SocialistDalao/UltraMIPS_Cache/ICache.runs/synth_1/.vivado.begin.rst

<?xml version="1.0"?>
<ProcessHandle Version="1" Minor="0">
    <Process Command="vivado.bat" Owner="lenovo" Host="DESKTOP-JDSOAL1" Pid="6020" HostCore="8" HostMemory="017082019840">
    </Process>
</ProcessHandle>
