SocialistDalao/UltraMIPS_Cache/ICache.runs/bank_ram_synth_1/.vivado.begin.rst

<?xml version="1.0"?>
<ProcessHandle Version="1" Minor="0">
    <Process Command="vivado.bat" Owner="Lenovo" Host="DESKTOP-DE0831E" Pid="9336" HostCore="12" HostMemory="017056509952">
    </Process>
</ProcessHandle>
