SocialistDalao/UltraMIPS_Cache/Resource/pref_pass_49/myCPU/Readme.md

大赛要求的顶层模块：mycpu_top（待修改）

cpu外的顶层模块：CacheBeta1以及my_axi_interface

宏定义：defines_cache

其他文件包含在模块内部，顶层接线不需要涉及。
