SocialistDalao/UltraMIPS_Cache/Thoughts.md

# Cache开发说明

当前目录下为成品的流水ICache与成品的DCache。目前ICache支持双发，具体更新见Cache_Desgin.md

#### 流水线思考

DCache的一部分遗留问题如下：首先是结构和状态机不能够与流水线进行对接，同时整个流水线的结构显得扑朔迷离，不仅如此，当前的代码和数据通路的构造显得不够清晰和合理，状态机的设计也存在着相当的不合理性。关于将bank的各部分的写使能分开，不要一起写，这个等整个的功能一步一步开发之后再进行重构和关键路径的优化。还有就是假如是两级的流水线，那么如果读和（脏数据）写冲突了，那么就应该是写优先。写数据会比读数据慢一拍，这样的话就刚好碰在一起，就不用读RAM了，只执行写操作，对于读操作直接拿写的数据就好了（好有道理，这不就解决了写相关）。

对于信号func，之后切成流水的时候要注意到流水线中的无效情况，也是就是不是二选一的关系，还需要加入无效。则之后换成write_valid和read_valid信号。

cache这边基本确定，取指和访存最好是三级而非两级，也就是cpu至少是7级流水。

只要是流水，就不得不考虑到数据冲突，对于读将要写的似乎显得容易解决，但是如果是考虑到WriteBuffer，似乎一切都不是那么简单。写WriteBuffer的时候也有可能同时在读，其中会不会出现数据冲突呢？所以在构建流水之前还是需要先思考一下Cache中的数据通路，准确而优雅的展示出硬件框图和其中的联系关系。

#### 状态机非流水思考

##### 状态机

现在的状态机基本符合预期，但是在Look Up和Write Data两个状态没有太多的操作，很多操作都在fetch data中，其中写ram的操作也在这里完成，因此可以考虑之后从中分配一部分操作出去。

##### WriteBuffer满

当前，我们设计的DCache为当从总线获得数据的时候，对buffer写入脏块，当buffer为满的时候，我们设计暂停，但是注意，这样导致弹出来的快丢失了。所以我们应该要在一开始就暂停住状态机，在buffer满的时候不进行工作。但是由于我们的buffer较大，现在还没有遇到这种问题，因此我们暂时不修复。

#### 结构设计文档

对于cache的结构和设计的思想的文档都在Cache_Design.md中，但是里面目前的不仅不全面而且有部分未更新，并且排版偏向混乱，至于具体的结构设计文档，包括硬件框图，都会在单发射性能测试成功后或者是双发射性能测试成功之后进行补充。为了方便团队内部和之后学校内部的传承，这都是必须要做的事情。

至于开源版本，可能会有一定设计上的精简，考虑到整个比赛的良性循环以及学习精神，开源版本应该附加的Cache Design更加注重原理上而非细节上的设计，这两个版本将为校内同学的学习提供Cache设计的参考。

结构设计文档应该要详细的标注出各个端口和各个部件的功能特性和时序图，不能够草草了事。

#### 紧接着要做的事情

- DCache仿真

#### 剩余待实现的功能

- 流水切割（初具成果的cache）
- Cache指令
- 硬件初始化（决赛的基本要求）
- 指令预取
- 双发射（最终成品的cache的基础版）
- 开发文档和结构设计的撰写
- 这之后就是各种提升性能的关键所在了
