SocialistDalao/UltraMIPS_Cache/Resource/PastVersion/7.28中午将分支预测正确工作.md

### 版本

7.28noon：功能测试通过。性能测试有分，但是部分不显示，应该是axi跑飞了。

### 进程

7.28中午将分支预测正确工作

7.27晚 dcache过了性能测试
