SocialistDalao/UltraMIPS_Cache/Resource/PastVersion/7.28noon-InstUncached/ctrl.v

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
`include "defines.v"

module ctrl(
	input resetn,
	input stallreq_from_id,
	input stallreq_from_ex,
	input stallreq_from_icache,
	input stallreq_from_dcache,
	input pred_flag,
	input exception_flag,
	input[4:0] exception_type,
	input[`InstAddrBus] cp0_epc_i,
	
	output reg[5:0]          stall,
	output reg               flush,
	output reg               flush_cause,
	output reg[`InstAddrBus] epc_o

);

	always @ (*) begin
		if (resetn == `RstEnable) stall = 6'b000000;
		else if (stallreq_from_dcache == `Stop) stall = 6'b011111;
		else if (stallreq_from_ex == `Stop) stall = 6'b001111;
		else if (stallreq_from_id == `Stop) stall = 6'b000111;
		else if (stallreq_from_icache == `Stop) stall = 6'b000111;
		else stall = 6'b000000;
	end
	
	always @ (*) begin
	   if (resetn == `RstEnable) begin
	       flush = `NoFlush;
	       flush_cause = `Exception;
	       epc_o = `ZeroWord;
	   end else if (exception_flag == `ExceptionInduced) begin
	       flush = `Flush;
	       flush_cause = `Exception;
	       case (exception_type)
	       `EXCEPTION_INT, `EXCEPTION_ADEL, `EXCEPTION_ADES, `EXCEPTION_SYS,
	       `EXCEPTION_BP, `EXCEPTION_RI, `EXCEPTION_OV, `EXCEPTION_TR: epc_o = `VECTOR_EXCEPTION;
	       `EXCEPTION_ERET: epc_o = cp0_epc_i;
	       default: epc_o = `ZeroWord;
	       endcase
	   end else if (pred_flag == `InvalidPrediction) begin
	       flush = `Flush;
	       flush_cause = `FailedBranchPrediction;
	       epc_o = `ZeroWord;
	   end else begin
	       flush = `NoFlush;
	       flush_cause = `Exception;
	       epc_o = `ZeroWord;
	   end
	end

endmodule
