SocialistDalao/UltraMIPS_Cache/Resource/submission_prelininary/src/mycpu/mycpu.v

//////////////////////////////////////////////////////////////////////////////////
// Company: 
// Engineer: 
// 
// Create Date: 2020/06/24 16:48:43
// Design Name: 
// Module Name: mycpu
// Project Name: 
// Target Devices: 
// Tool Versions: 
// Description: 
// 
// Dependencies: 
// 
// Revision:
// Revision 0.01 - File Created
// Additional Comments:
// 
//////////////////////////////////////////////////////////////////////////////////


module mycpu(
    input clk,
    input resetn,
    input[5:0] int,
    output flush,
    output timer_int_o,
    
    // 与I-cache交流
    input stallreq_from_icache,
    input[`InstBus] inst1_from_icache,
    input[`InstBus] inst2_from_icache,
    input[`InstAddrBus] inst1_addr_from_icache,
    input[`InstAddrBus] inst2_addr_from_icache,
    input[`SIZE_OF_CORR_PACK] corr_pack0_from_cache_o,
    input[`SIZE_OF_CORR_PACK] corr_pack1_from_cache_o,
    input inst1_valid_from_icache,
    input inst2_valid_from_icache,
    output rreq_to_icache,
    output[`InstAddrBus] raddr_to_icache,
    
    //Cache Pc Control
    input [`InstAddrBus] npc_from_cache_i,
    
    //bpu
    output[`SIZE_OF_CORR_PACK] corr_pack0_to_cache_o,
    output[`SIZE_OF_CORR_PACK] corr_pack1_to_cache_o,
	output 				is_pc_branch_i,
	output 				is_pcPlus4_branch_i,
	output [`InstAddrBus]	pc_branch_dest_i,
	output [`InstAddrBus]	pcPlus4_branch_dest_i,
    
    // 与D-cache交流
    input[`RegBus] rdata_from_dcache,
    input stallreq_from_dcache,
    output rreq_to_dcache,
    output[`DataAddrBus] raddr_to_dcache,
    output wreq_to_dcache,
    output[`DataAddrBus] waddr_to_dcache,
    output[`RegBus] wdata_to_dcache,
    output[3:0] wsel_to_dcache,
    
    // debug信号
    output[`InstAddrBus]           commit_pc1,
	output                         commit_rf_wen1,
	output[4:0]                    commit_rf_waddr1,
	output[`RegBus]                commit_rf_wdata1,
	
	output[`InstAddrBus]           commit_pc2,
	output                         commit_rf_wen2,
	output[`RegAddrBus]            commit_rf_waddr2,
	output[`RegBus]                commit_rf_wdata2
    
    );
    
    wire[3:0] stall;
    wire flush_cause;
    wire flush_to_ibuffer;
    wire stallreq_from_ex;
    wire stallreq_from_id;
    wire[`InstAddrBus] epc_o;
    wire ibuffer_full;
    
    wire rf_we1;
    wire rf_we2;
    wire[`RegAddrBus] rf_waddr1;
    wire[`RegAddrBus] rf_waddr2;
    wire[`RegAddrBus] rf_raddr1;
    wire[`RegAddrBus] rf_raddr2;
    wire[`RegAddrBus] rf_raddr3;
    wire[`RegAddrBus] rf_raddr4;
    wire[`RegBus] rf_wdata1;
    wire[`RegBus] rf_wdata2;
    wire[`RegBus] rf_rdata1;
    wire[`RegBus] rf_rdata2;
    wire[`RegBus] rf_rdata3;
    wire[`RegBus] rf_rdata4;
    
    wire[`RegBus] hi_i;
    wire[`RegBus] lo_i;
    wire we_hilo;
    wire[`RegBus] hi_o;
    wire[`RegBus] lo_o;
    
    wire LLbit_i;    

    wire LLbit_we;
    wire LLbit_o;
    wire cp0_we;
    wire[2:0] cp0_wsel;
    wire[2:0] cp0_rsel;
    wire[`RegAddrBus] cp0_waddr;
    wire[`RegAddrBus] cp0_raddr;
    wire[`RegBus] cp0_wdata;
    wire[`RegBus] cp0_rdata;
    wire[`RegBus] cp0_badvaddr;
    wire[`RegBus] cp0_count;
    wire[`RegBus] cp0_compare;
    wire[`RegBus] cp0_status;
    wire[`RegBus] cp0_cause;
    wire[`RegBus] cp0_epc;
    wire[`RegBus] cp0_config;
    wire[`RegBus] cp0_prid;
    wire[`RegBus] cp0_ebase;
    
    
    wire[`SIZE_OF_CORR_PACK] inst1_bpu_corr_i;
    wire[`SIZE_OF_CORR_PACK] inst2_bpu_corr_i;
    wire[`SIZE_OF_BRANCH_INFO] branch_info_i;
    
    wire id_issue_en_i;
    wire[`InstBus] id_inst1_i;
    wire[`InstBus] id_inst2_i;
    wire[`InstAddrBus] id_inst1_addr_i;
    wire[`InstAddrBus] id_inst2_addr_i;
    wire[`SIZE_OF_CORR_PACK] id_inst1_bpu_corr_i;
    wire[`SIZE_OF_CORR_PACK] id_inst2_bpu_corr_i;
    
    wire id_is_in_delayslot_i;
    
    
    wire[`InstAddrBus] id_inst1_addr_o;
    wire[`InstAddrBus] id_inst2_addr_o;
    wire[`SIZE_OF_CORR_PACK] id_inst1_bpu_corr_o;
    wire[`SIZE_OF_CORR_PACK] id_inst2_bpu_corr_o;
    wire[`AluOpBus] id_aluop1_o;
    wire[`AluOpBus] id_aluop2_o;
    wire[`AluSelBus] id_alusel1_o;
    wire[`AluSelBus] id_alusel2_o;
    wire[`RegBus] id_reg1_o;
    wire[`RegBus] id_reg2_o;
    wire[`RegBus] id_reg3_o;
    wire[`RegBus] id_reg4_o;
    wire[`RegAddrBus] id_waddr1_o;
    wire[`RegAddrBus] id_waddr2_o;
    wire id_we1_o;
    wire id_we2_o;
    wire[`RegBus] id_hi_o;
    wire[`RegBus] id_lo_o;
    wire[`RegBus] id_imm_fnl1_o;
    wire[2:0] id_cp0_sel_o;
    wire[`RegAddrBus] id_cp0_addr_o;
    wire id_issue_mode_o;
    wire id_issued_o;
    wire id_is_in_delayslot1_o;
    wire id_is_in_delayslot2_o;
    wire next_inst_in_delayslot;
    wire[31:0] id_exception_type1_o;
    wire[31:0] id_exception_type2_o;
    
    wire mul_s;
    wire mul_req;
    wire mul_ready;
    wire[`DoubleRegBus] mul_result;
    
    wire signed_div;
    wire[`RegBus] div_opdata1;
    wire[`RegBus] div_opdata2;
    wire div_start;
    wire[`DoubleRegBus] div_result;
    wire div_ready;
    
    wire[`InstAddrBus] ex_inst1_addr_i;
    wire[`InstAddrBus] ex_inst2_addr_i;
    wire[`SIZE_OF_CORR_PACK] ex_inst1_bpu_corr_i;
    wire[`SIZE_OF_CORR_PACK] ex_inst2_bpu_corr_i;
    wire[`AluOpBus] ex_aluop1_i;
    wire[`AluOpBus] ex_aluop2_i;
    wire[`AluSelBus] ex_alusel1_i;
    wire[`AluSelBus] ex_alusel2_i;
    wire[`RegBus] ex_reg1_i;
    wire[`RegBus] ex_reg2_i;
    wire[`RegBus] ex_reg3_i;
    wire[`RegBus] ex_reg4_i;
    wire[`RegAddrBus] ex_waddr1_i;
    wire[`RegAddrBus] ex_waddr2_i;
    wire ex_we1_i;
    wire ex_we2_i;
    wire[`RegBus] ex_hi_i;
    wire[`RegBus] ex_lo_i;
    wire[`RegBus] ex_imm_fnl1_i;
    wire ex_issue_i;
    wire[2:0] ex_cp0_sel_i;
    wire[`RegAddrBus] ex_cp0_addr_i;
    wire ex_is_in_delayslot1_i;
    wire ex_is_in_delayslot2_i;
    wire[31:0] ex_exception_type1_i;
    wire[31:0] ex_exception_type2_i;
    
    wire[`InstAddrBus] ex_inst1_addr_o;
    wire[`InstAddrBus] ex_inst2_addr_o;
    wire[`SIZE_OF_CORR_PACK] ex_inst1_bpu_corr_o;
    wire[`SIZE_OF_CORR_PACK] ex_inst2_bpu_corr_o;
    wire[`RegAddrBus] ex_waddr1_o;
    wire[`RegAddrBus] ex_waddr2_o;
    wire ex_we1_o;
    wire ex_we2_o;
    wire[`RegBus] ex_wdata1_o;
    wire[`RegBus] ex_wdata2_o;
    wire[`RegBus] ex_hi_o;
    wire[`RegBus] ex_lo_o;
    wire ex_whilo_o;
    wire[`AluOpBus] ex_aluop1_o;
    wire[`RegBus] ex_mem_addr_o;
    wire[`RegBus] ex_reg2_o;
    wire ex_LLbit_o;
    wire ex_LLbit_we_o;
    wire[`InstAddrBus] ex_npc_actual_o;
    wire ex_branch_flag_o;
	wire ex_pred_flag_o;
    wire[`SIZE_OF_BRANCH_INFO] ex_branch_info_o;
	wire ex_issue_mode_o;
    wire[2:0] ex_cp0_wsel_o;
	wire ex_cp0_we_o;
	wire[`RegAddrBus] ex_cp0_waddr_o;
	wire[`RegBus] ex_cp0_wdata_o;
	wire ex_is_in_delayslot1_o;
    wire ex_is_in_delayslot2_o;
    wire[31:0] ex_exception_type1_o;
    wire[31:0] ex_exception_type2_o;
    
    wire[`InstAddrBus] mem_inst1_addr_i;
    wire[`InstAddrBus] mem_inst2_addr_i;
    wire[`RegAddrBus] mem_waddr1_i;
    wire[`RegAddrBus] mem_waddr2_i;
    wire mem_we1_i;
    wire mem_we2_i;
    wire[`RegBus] mem_wdata1_i;
    wire[`RegBus] mem_wdata2_i;
    wire[`RegBus] mem_hi_i;
    wire[`RegBus] mem_lo_i;
    wire mem_whilo_i;
    wire[`AluOpBus] mem_aluop1_i;
    wire[`RegBus] mem_mem_addr_i;
    wire[`RegBus] mem_reg2_i;
    wire mem_LLbit_i;
    wire mem_LLbit_we_i;
    wire[2:0] mem_cp0_wsel_i;
    wire mem_cp0_we_i;
	wire[`RegAddrBus] mem_cp0_waddr_i;
	wire[`RegBus] mem_cp0_wdata_i;
	wire mem_is_in_delayslot1_i;
    wire mem_is_in_delayslot2_i;
    wire[31:0] mem_exception_type1_i;
    wire[31:0] mem_exception_type2_i;
    
    wire[`InstAddrBus] mem_inst1_addr_o;
    wire[`InstAddrBus] mem_inst2_addr_o;
    wire[`RegAddrBus] mem_waddr1_o;
    wire[`RegAddrBus] mem_waddr2_o;
    wire mem_we1_o;
    wire mem_we2_o;
    wire[`RegBus] mem_wdata1_o;
    wire[`RegBus] mem_wdata2_o;
    wire[`RegBus] mem_hi_o;
    wire[`RegBus] mem_lo_o;
    wire mem_whilo_o;
    wire[`RegBus] mem_mem_addr_o;
    wire mem_LLbit_o;
    wire mem_LLbit_we_o;
    wire[2:0] mem_cp0_wsel_o;
    wire mem_cp0_we_o;
	wire[`RegAddrBus] mem_cp0_waddr_o;
	wire[`RegBus] mem_cp0_wdata_o;
	wire mem_is_in_delayslot1_o;
    wire mem_is_in_delayslot2_o;
    wire[4:0] mem_exception_type_o;
    wire mem_exception_flag_o;
    wire mem_exception_first_inst_o;
    wire[`InstAddrBus] latest_epc;
    wire[`InstAddrBus] mem_ebase_o;
    wire[`InstAddrBus] commit_pc_o;
    
    // Debug信号
    
    assign commit_pc1 = commit_pc_o;
    assign commit_rf_wen1 = rf_we1;
    assign commit_rf_waddr1 = rf_waddr1;
    assign commit_rf_wdata1 = rf_wdata1;
    assign commit_pc2 = commit_pc_o + 4'h4;
    assign commit_rf_wen2 = rf_we2;
    assign commit_rf_waddr2 = rf_waddr2;
    assign commit_rf_wdata2 = rf_wdata2;
    
    ctrl u_ctrl(
        .resetn(resetn),
        .stallreq_from_ex(stallreq_from_ex),
        .stallreq_from_id(stallreq_from_id),
        .stallreq_from_dcache(stallreq_from_dcache),
        .pred_flag(ex_pred_flag_o),
        .exception_flag(mem_exception_flag_o),
        .exception_type(mem_exception_type_o),
        .cp0_epc_i(latest_epc),
        .ebase_i(mem_ebase_o),
        .stall(stall),
        .flush(flush),
        .flush_cause(flush_cause),
        .epc_o(epc_o),
        .flush_to_ibuffer(flush_to_ibuffer)
        );
    
    pc_reg u_pc(
        .clk(clk),
        .resetn(resetn),
        .stall(stall),
        .flush(flush),
        .flush_cause(flush_cause),
        .stallreq_from_icache(stallreq_from_icache),
        .branch_flag(ex_branch_flag_o),
        .npc_actual(ex_npc_actual_o),
        .ex_pc(ex_inst1_addr_o),
        .npc_from_cache(npc_from_cache_i),
        .epc(epc_o),
        .ibuffer_full(ibuffer_full),
        .pc(raddr_to_icache),
        .rreq_to_icache(rreq_to_icache)
        );
        
    /*
    branch_prediction bp0(
        .resetn(resetn),                                 
        .clk   (clk   ),                                    
        .stall (stallreq_from_ex == `Branch || stallreq_from_dcache == `Branch),  //stall from ex!!!                
                                                
        .pc(raddr_to_icache),                            
        .pc_p4(raddr_to_icache+32'h4),   //from cache              
                                                 
        .ex_branch_info0(branch_info_i),  //from ex
       // .ex_branch_info1(),                 
        
        .corr_pack0_o(corr_pack0_to_cache_o),// to icache/inst buffer
        .corr_pack1_o(corr_pack1_to_cache_o),    
        
        .corr_pack0_i(inst1_bpu_corr_i),//from ex_mem 
        .corr_pack1_i(inst2_bpu_corr_i),
          
                                               
                                              
        .pta0({is_pc_branch_i,pc_branch_dest_i}),   //33bit:是否跳1bit + 32bit跳的地址
        .pta1({is_pcPlus4_branch_i,pcPlus4_branch_dest_i})    //to icache
                                              
        
        );*/
    //assign corr_pack0_to_cache_o = 0;
    //assign corr_pack1_to_cache_o = 0;    
    
    branch_predictor_lite bpl0(
        .resetn(resetn),                                 
        .clk   (clk   ),                                    
        .stall (stallreq_from_ex == `Branch || stallreq_from_dcache == `Branch),
        
        .pc(raddr_to_icache),                            
        .pc_p4(raddr_to_icache+32'h4),   //from cache        
        
        .branch_info0(branch_info_i),
        
        .pta0({is_pc_branch_i,pc_branch_dest_i}),   //33bit:是否跳1bit + 32bit跳的地址
        .pta1({is_pcPlus4_branch_i,pcPlus4_branch_dest_i}),    //to icache
        
        .corr_pack0_o(corr_pack0_to_cache_o),// to icache/inst buffer
        .corr_pack1_o(corr_pack1_to_cache_o)    
        
    );    
    
        
    InstBuffer u_ib(
        .clk(clk),
        .rst(~resetn),
        .flush(flush_to_ibuffer),
        .issue_mode_i(id_issue_mode_o),
        .issue_i(id_issued_o),
        .issue_inst1_o(id_inst1_i),
        .issue_inst2_o(id_inst2_i),
        .issue_inst1_addr_o(id_inst1_addr_i),
        .issue_inst2_addr_o(id_inst2_addr_i),
        .issue_bpu_corr1_o(id_inst1_bpu_corr_i),
        .issue_bpu_corr2_o(id_inst2_bpu_corr_i),
        .issue_ok_o(id_issue_en_i),
        .ICache_inst1_i(inst1_from_icache),
        .ICache_inst2_i(inst2_from_icache),
        .ICache_inst1_addr_i(inst1_addr_from_icache),
        .ICache_inst2_addr_i(inst2_addr_from_icache),
        .bpu_corr1_i(corr_pack0_from_cache_o),
        .bpu_corr2_i(corr_pack1_from_cache_o),
        .ICache_inst1_valid_o(inst1_valid_from_icache),
        .ICache_inst2_valid_o(inst2_valid_from_icache),
	    .buffer_full_o(ibuffer_full)
        );
    
    regfile u_regfile(
        .clk(clk),
        .rst(resetn),
        .we1(rf_we1),
        .waddr1(rf_waddr1),
        .wdata1(rf_wdata1),
        .we2(rf_we2),
        .waddr2(rf_waddr2),
        .wdata2(rf_wdata2),
        .raddr1(rf_raddr1),
        .rdata1(rf_rdata1),
        .raddr2(rf_raddr2),
        .rdata2(rf_rdata2),
        .raddr3(rf_raddr3),
        .rdata3(rf_rdata3),
        .raddr4(rf_raddr4),
        .rdata4(rf_rdata4)
        );
    
    hilo_reg u_hlreg(
        .clk(clk),
        .rst(resetn),
        .we(we_hilo),
        .hi_i(hi_i),
        .lo_i(lo_i),
        .hi_o(hi_o),
        .lo_o(lo_o)
        );
        
    LLbit_reg u_LLbit(
        .clk(clk),
        .rst(resetn),
        .flush(flush),
        .flush_cause(flush_cause),
        .LLbit_i(LLbit_i),
        .we(LLbit_we),
        .LLbit_o(LLbit_o)
        );
    
    cp0_reg u_cp0(
        .clk(clk),
        .resetn(resetn),
        .we_i(cp0_we),
        .waddr_i(cp0_waddr),
        .wsel_i(cp0_wsel),
        .raddr_i(cp0_raddr),
        .rsel_i(cp0_rsel),
        .data_i(cp0_wdata),
	    .exception_type_i(mem_exception_type_o),
	    .exception_flag_i(mem_exception_flag_o),
	    .exception_first_inst_i(mem_exception_first_inst_o),
	    .inst1_addr_i(mem_inst1_addr_o),
	    .inst2_addr_i(mem_inst2_addr_o),
	    .mem_addr_i(mem_mem_addr_o),
	    .is_in_delayslot1_i(mem_is_in_delayslot1_o),
	    .is_in_delayslot2_i(mem_is_in_delayslot2_o),
        .int_i(int),
        .data_o(cp0_rdata),
        .badvaddr_o(cp0_badvaddr),
        .count_o(cp0_count),
        .compare_o(cp0_compare),
        .status_o(cp0_status),
        .cause_o(cp0_cause),
        .epc_o(cp0_epc),
        .config_o(cp0_config),
        .prid_o(cp0_prid),
        .ebase_o(cp0_ebase),
        .timer_int_o(timer_int_o)
        );
        
    id u_id(
        .rst(resetn),
        .stallreq_from_ex(stallreq_from_ex),
        .stallreq_from_dcache(stallreq_from_dcache),
        .inst1_i(id_inst1_i),
        .inst2_i(id_inst2_i),
        .inst1_addr_i(id_inst1_addr_i),
        .inst2_addr_i(id_inst2_addr_i),
        .inst1_bpu_corr_i(id_inst1_bpu_corr_i),
        .inst2_bpu_corr_i(id_inst2_bpu_corr_i),
        .issue_en_i(id_issue_en_i),
        .is_in_delayslot_i(id_is_in_delayslot_i),
        .reg1_data_i(rf_rdata1),
        .reg2_data_i(rf_rdata2),
        .reg3_data_i(rf_rdata3),
        .reg4_data_i(rf_rdata4),
        .ex_waddr1_i(ex_waddr1_o),
	    .ex_waddr2_i(ex_waddr2_o),
	    .ex_we1_i(ex_we1_o),
        .ex_we2_i(ex_we2_o),
        .ex_wdata1_i(ex_wdata1_o),
        .ex_wdata2_i(ex_wdata2_o),
        .mem_waddr1_i(mem_waddr1_o),
        .mem_waddr2_i(mem_waddr2_o),
        .mem_we1_i(mem_we1_o),
        .mem_we2_i(mem_we2_o),
        .mem_wdata1_i(mem_wdata1_o),
        .mem_wdata2_i(mem_wdata2_o),
        .ex_aluop1_i(ex_aluop1_o),
        .hi_i(hi_o),
        .lo_i(lo_o),
        .ex_hi_i(ex_hi_o),
        .ex_lo_i(ex_lo_o),
        .ex_whilo_i(ex_whilo_o),
        .mem_hi_i(mem_hi_o),
        .mem_lo_i(mem_lo_o),
        .mem_whilo_i(mem_whilo_o),
        .commit_hi_i(hi_i),
        .commit_lo_i(lo_i),
        .commit_whilo_i(we_hilo),
        .inst1_addr_o(id_inst1_addr_o),
        .inst2_addr_o(id_inst2_addr_o),
        .inst1_bpu_corr_o(id_inst1_bpu_corr_o),
        .inst2_bpu_corr_o(id_inst2_bpu_corr_o),
        .reg1_raddr_o(rf_raddr1),
        .reg2_raddr_o(rf_raddr2),
        .reg3_raddr_o(rf_raddr3),
        .reg4_raddr_o(rf_raddr4),
        .aluop1_o(id_aluop1_o),
        .alusel1_o(id_alusel1_o),
        .aluop2_o(id_aluop2_o),
        .alusel2_o(id_alusel2_o),
        .reg1_o(id_reg1_o),
        .reg2_o(id_reg2_o),
        .reg3_o(id_reg3_o),
        .reg4_o(id_reg4_o),
        .waddr1_o(id_waddr1_o),
        .waddr2_o(id_waddr2_o),
        .we1_o(id_we1_o),
        .we2_o(id_we2_o),
        .hi_o(id_hi_o),
        .lo_o(id_lo_o),
        .is_in_delayslot1_o(id_is_in_delayslot1_o),
        .is_in_delayslot2_o(id_is_in_delayslot2_o),
        .imm_fnl1_o(id_imm_fnl1_o),
        .ninst_in_delayslot(next_inst_in_delayslot),
        .cp0_addr_o(id_cp0_addr_o),
        .cp0_sel_o(id_cp0_sel_o),
        .exception_type1(id_exception_type1_o),
        .exception_type2(id_exception_type2_o),
        .issue_o(id_issue_mode_o),
        .issued_o(id_issued_o),
        .stallreq_from_id(stallreq_from_id)
        );
    
    id_ex u_id_ex(
        .clk(clk),
        .resetn(resetn),
        .flush(flush),
        .flush_cause(flush_cause),
        .stall(stall),
        .inst1_addr_i(id_inst1_addr_o),
        .inst2_addr_i(id_inst2_addr_o),
        .inst1_bpu_corr_i(id_inst1_bpu_corr_o),
        .inst2_bpu_corr_i(id_inst2_bpu_corr_o),
        .aluop1_i(id_aluop1_o),
        .alusel1_i(id_alusel1_o),
        .aluop2_i(id_aluop2_o),
        .alusel2_i(id_alusel2_o),
        .reg1_i(id_reg1_o),
        .reg2_i(id_reg2_o),
        .reg3_i(id_reg3_o),
        .reg4_i(id_reg4_o),
        .waddr1_i(id_waddr1_o),
        .waddr2_i(id_waddr2_o),
        .we1_i(id_we1_o),
        .we2_i(id_we2_o),
        .hi_i(id_hi_o),
        .lo_i(id_lo_o),
	    .imm_fnl1_i(id_imm_fnl1_o),
	    .issue_i(id_issue_mode_o),
	    .ex_issue_mode_i(ex_issue_mode_o),
        .cp0_sel_i(id_cp0_sel_o),
	    .cp0_addr_i(id_cp0_addr_o),
	    .next_inst_in_delayslot_i(next_inst_in_delayslot),
	    .is_in_delayslot1_i(id_is_in_delayslot1_o),
	    .is_in_delayslot2_i(id_is_in_delayslot2_o),
	    .exception_type1_i(id_exception_type1_o),
        .exception_type2_i(id_exception_type2_o),
        .inst1_addr_o(ex_inst1_addr_i),
        .inst2_addr_o(ex_inst2_addr_i),
        .inst1_bpu_corr_o(ex_inst1_bpu_corr_i),
        .inst2_bpu_corr_o(ex_inst2_bpu_corr_i),
        .aluop1_o(ex_aluop1_i),
        .alusel1_o(ex_alusel1_i),
        .aluop2_o(ex_aluop2_i),
        .alusel2_o(ex_alusel2_i),
        .reg1_o(ex_reg1_i),
        .reg2_o(ex_reg2_i),
        .reg3_o(ex_reg3_i),
        .reg4_o(ex_reg4_i),
        .waddr1_o(ex_waddr1_i),
        .waddr2_o(ex_waddr2_i),
        .we1_o(ex_we1_i),
        .we2_o(ex_we2_i),
        .hi_o(ex_hi_i),
        .lo_o(ex_lo_i),
	    .imm_fnl1_o(ex_imm_fnl1_i),
	    .issue_o(ex_issue_i),
	    .cp0_sel_o(ex_cp0_sel_i),
	    .cp0_addr_o(ex_cp0_addr_i),
	    .next_inst_in_delayslot_o(id_is_in_delayslot_i),
	    .is_in_delayslot1_o(ex_is_in_delayslot1_i),
	    .is_in_delayslot2_o(ex_is_in_delayslot2_i),
	    .exception_type1_o(ex_exception_type1_i),
        .exception_type2_o(ex_exception_type2_i)
        );
    
    mul u_mul(
        .clk(clk),
        .resetn(resetn),
        .flush(flush),
        .flush_cause(flush_cause),
        .request(mul_req),
        .x(ex_reg1_i),
        .y(ex_reg2_i),
        .s(mul_s),
        .ready(mul_ready),
        .z(mul_result)
        );
    
    div u_div(
        .clk(clk),
        .rst(resetn),
        .signed_div_i(signed_div),
        .opdata1_i(div_opdata1),
        .opdata2_i(div_opdata2),
        .start_i(div_start),
        .annul_i(flush == `Flush && flush_cause == `Exception),
        .result_o(div_result),
        .ready_o(div_ready)
        );
    
    ex u_ex(
        .rst(resetn),
        .inst1_addr_i(ex_inst1_addr_i),
        .inst2_addr_i(ex_inst2_addr_i),
        .inst1_bpu_corr_i(ex_inst1_bpu_corr_i),
        .inst2_bpu_corr_i(ex_inst2_bpu_corr_i),
        .aluop1_i(ex_aluop1_i),
        .alusel1_i(ex_alusel1_i),
        .aluop2_i(ex_aluop2_i),
        .alusel2_i(ex_alusel2_i),
        .reg1_i(ex_reg1_i),
        .reg2_i(ex_reg2_i),
        .reg3_i(ex_reg3_i),
        .reg4_i(ex_reg4_i),
        .waddr1_i(ex_waddr1_i),
        .waddr2_i(ex_waddr2_i),
        .we1_i(ex_we1_i),
        .we2_i(ex_we2_i),
        .mul_ready_i(mul_ready),
        .mul_i(mul_result),
        .div_result_i(div_result),
        .div_ready_i(div_ready),
        .hi_i(ex_hi_i),
        .lo_i(ex_lo_i),
        .imm_fnl1_i(ex_imm_fnl1_i),
	    .issue_i(ex_issue_i),
	    .is_in_delayslot1_i(ex_is_in_delayslot1_i),
	    .is_in_delayslot2_i(ex_is_in_delayslot2_i),
	    .LLbit_i(LLbit_o),
	    .mem_LLbit_i(mem_LLbit_o),
	    .mem_LLbit_we_i(mem_LLbit_we_o),
	    .commit_LLbit_i(LLbit_i),
	    .commit_LLbit_we_i(LLbit_we),
        .cp0_sel_i(ex_cp0_sel_i),
	    .cp0_addr_i(ex_cp0_addr_i),
	    .cp0_data_i(cp0_rdata),
        .mem_cp0_wsel_i(mem_cp0_wsel_o),
	    .mem_cp0_we_i(mem_cp0_we_o),
        .mem_cp0_waddr_i(mem_cp0_waddr_o),
        .mem_cp0_wdata_i(mem_cp0_wdata_o),
        .commit_cp0_wsel_i(cp0_wsel),
	    .commit_cp0_we_i(cp0_we),
	    .commit_cp0_waddr_i(cp0_waddr),
	    .commit_cp0_wdata_i(cp0_wdata),
	    .mem_exception_flag_i(mem_exception_flag_o),
	    .exception_type1_i(ex_exception_type1_i),
        .exception_type2_i(ex_exception_type2_i),
        .inst1_addr_o(ex_inst1_addr_o),
        .inst2_addr_o(ex_inst2_addr_o),
        .inst1_bpu_corr_o(ex_inst1_bpu_corr_o),
        .inst2_bpu_corr_o(ex_inst2_bpu_corr_o),
        .waddr1_o(ex_waddr1_o),
        .waddr2_o(ex_waddr2_o),
        .we1_o(ex_we1_o),
        .we2_o(ex_we2_o),
        .wdata1_o(ex_wdata1_o),
        .wdata2_o(ex_wdata2_o),
        .mul_req_o(mul_req),
        .mul_s_o(mul_s),
        .hi_o(ex_hi_o),
        .lo_o(ex_lo_o),
        .whilo_o(ex_whilo_o),
        .npc_actual(ex_npc_actual_o),
	    .branch_flag_actual(ex_branch_flag_o),
	    .pred_flag(ex_pred_flag_o),
	    .branch_info(ex_branch_info_o),
	    .issue_mode(ex_issue_mode_o),
        .is_in_delayslot1_o(ex_is_in_delayslot1_o),
	    .is_in_delayslot2_o(ex_is_in_delayslot2_o),
        .div_opdata1_o(div_opdata1),
        .div_opdata2_o(div_opdata2),
        .div_start_o(div_start),
        .signed_div_o(signed_div),
        .aluop1_o(ex_aluop1_o),
        .mem_addr_o(ex_mem_addr_o),
        .reg2_o(ex_reg2_o),
        .mem_raddr_o(raddr_to_dcache),
        .mem_waddr_o(waddr_to_dcache),
	    .mem_we_o(wreq_to_dcache),
	    .mem_sel_o(wsel_to_dcache),
	    .mem_data_o(wdata_to_dcache),
	    .mem_re_o(rreq_to_dcache),
	    .LLbit_o(ex_LLbit_o),
	    .LLbit_we_o(ex_LLbit_we_o),
        .cp0_rsel_o(cp0_rsel),
        .cp0_raddr_o(cp0_raddr),
        .cp0_wsel_o(ex_cp0_wsel_o),
        .cp0_we_o(ex_cp0_we_o),
	    .cp0_waddr_o(ex_cp0_waddr_o),
	    .cp0_wdata_o(ex_cp0_wdata_o),
	    .exception_type1_o(ex_exception_type1_o),
        .exception_type2_o(ex_exception_type2_o),
        .stallreq(stallreq_from_ex)
        );
    
    ex_mem u_ex_mem(
        .clk(clk),
        .rst(resetn),
        .flush(flush),
        .flush_cause(flush_cause),
        .stall(stall),
        .inst1_addr_i(ex_inst1_addr_o),
        .inst2_addr_i(ex_inst2_addr_o),
        .inst1_bpu_corr_i(ex_inst1_bpu_corr_o),
        .inst2_bpu_corr_i(ex_inst2_bpu_corr_o),
        .branch_info_i(ex_branch_info_o),
        .waddr1_i(ex_waddr1_o),
        .waddr2_i(ex_waddr2_o),
        .we1_i(ex_we1_o),
        .we2_i(ex_we2_o),
        .wdata1_i(ex_wdata1_o),
        .wdata2_i(ex_wdata2_o),
        .hi_i(ex_hi_o),
        .lo_i(ex_lo_o),
        .whilo_i(ex_whilo_o),
        .aluop1_i(ex_aluop1_o),
        .mem_addr_i(ex_mem_addr_o),
        .reg2_i(ex_reg2_o),
        .LLbit_i(ex_LLbit_o),
        .LLbit_we_i(ex_LLbit_we_o),
        .cp0_wsel_i(ex_cp0_wsel_o),
        .cp0_we_i(ex_cp0_we_o),
	    .cp0_waddr_i(ex_cp0_waddr_o),
	    .cp0_wdata_i(ex_cp0_wdata_o),
	    .is_in_delayslot1_i(ex_is_in_delayslot1_o),
	    .is_in_delayslot2_i(ex_is_in_delayslot2_o),
	    .exception_type1_i(ex_exception_type1_o),
        .exception_type2_i(ex_exception_type2_o),
        .inst1_addr_o(mem_inst1_addr_i),
        .inst2_addr_o(mem_inst2_addr_i),
        .inst1_bpu_corr_o(inst1_bpu_corr_i),
        .inst2_bpu_corr_o(inst2_bpu_corr_i),
        .branch_info_o(branch_info_i),
        .waddr1_o(mem_waddr1_i),
        .waddr2_o(mem_waddr2_i),
        .we1_o(mem_we1_i),
        .we2_o(mem_we2_i),
        .wdata1_o(mem_wdata1_i),
        .wdata2_o(mem_wdata2_i),
        .hi_o(mem_hi_i),
        .lo_o(mem_lo_i),
        .whilo_o(mem_whilo_i),
        .aluop1_o(mem_aluop1_i),
        .mem_addr_o(mem_mem_addr_i),
        .reg2_o(mem_reg2_i),
        .LLbit_o(mem_LLbit_i),
        .LLbit_we_o(mem_LLbit_we_i),
        .cp0_wsel_o(mem_cp0_wsel_i),
        .cp0_we_o(mem_cp0_we_i),
	    .cp0_waddr_o(mem_cp0_waddr_i),
	    .cp0_wdata_o(mem_cp0_wdata_i),
	    .is_in_delayslot1_o(mem_is_in_delayslot1_i),
	    .is_in_delayslot2_o(mem_is_in_delayslot2_i),
	    .exception_type1_o(mem_exception_type1_i),
        .exception_type2_o(mem_exception_type2_i)
        );
        
    mem u_mem(
        .rst(resetn),
        .mem_data_i(rdata_from_dcache),
        .inst1_addr_i(mem_inst1_addr_i),
        .inst2_addr_i(mem_inst2_addr_i),
        .waddr1_i(mem_waddr1_i),
        .waddr2_i(mem_waddr2_i),
        .we1_i(mem_we1_i),
        .we2_i(mem_we2_i),
        .wdata1_i(mem_wdata1_i),
        .wdata2_i(mem_wdata2_i),
        .hi_i(mem_hi_i),
        .lo_i(mem_lo_i),
        .whilo_i(mem_whilo_i),
        .aluop1_i(mem_aluop1_i),
        .mem_addr_i(mem_mem_addr_i),
        .reg2_i(mem_reg2_i),
        .LLbit_i(mem_LLbit_i),
        .LLbit_we_i(mem_LLbit_we_i),
        .cp0_wsel_i(mem_cp0_wsel_i),
        .cp0_we_i(mem_cp0_we_i),
	    .cp0_waddr_i(mem_cp0_waddr_i),
	    .cp0_wdata_i(mem_cp0_wdata_i),
	    .is_in_delayslot1_i(mem_is_in_delayslot1_i),
	    .is_in_delayslot2_i(mem_is_in_delayslot2_i),
	    .exception_type1_i(mem_exception_type1_i),
        .exception_type2_i(mem_exception_type2_i),
        .cp0_status_i(cp0_status),
        .cp0_cause_i(cp0_cause),
        .cp0_epc_i(cp0_epc),
        .cp0_ebase_i(cp0_ebase),
        .commit_cp0_wsel_i(cp0_wsel),
        .commit_cp0_we_i(cp0_we),
	    .commit_cp0_waddr_i(cp0_waddr),
	    .commit_cp0_wdata_i(cp0_wdata),
        .inst1_addr_o(mem_inst1_addr_o),
        .inst2_addr_o(mem_inst2_addr_o),
        .waddr1_o(mem_waddr1_o),
        .waddr2_o(mem_waddr2_o),
        .we1_o(mem_we1_o),
        .we2_o(mem_we2_o),
        .wdata1_o(mem_wdata1_o),
        .wdata2_o(mem_wdata2_o),
        .hi_o(mem_hi_o),
        .lo_o(mem_lo_o),
        .whilo_o(mem_whilo_o),
        .mem_addr_o(mem_mem_addr_o),
        .LLbit_o(mem_LLbit_o),
        .LLbit_we_o(mem_LLbit_we_o),
        .cp0_wsel_o(mem_cp0_wsel_o),
        .cp0_we_o(mem_cp0_we_o),
	    .cp0_waddr_o(mem_cp0_waddr_o),
	    .cp0_wdata_o(mem_cp0_wdata_o),
	    .exception_type_o(mem_exception_type_o),
	    .exception_flag_o(mem_exception_flag_o),
	    .exception_first_inst_o(mem_exception_first_inst_o),
	    .cp0_epc_o(latest_epc),
	    .cp0_ebase_o(mem_ebase_o),
	    .is_in_delayslot1_o(mem_is_in_delayslot1_o),
	    .is_in_delayslot2_o(mem_is_in_delayslot2_o)
        );
        
    commit u_commit(
        .clk(clk),
        .rst(resetn),
        .flush(flush),
        .flush_cause(flush_cause),
        .stall(stall),
        .pc_i(mem_inst1_addr_o),
        .waddr1_i(mem_waddr1_o),
        .waddr2_i(mem_waddr2_o),
        .we1_i(mem_we1_o),
        .we2_i(mem_we2_o),
        .wdata1_i(mem_wdata1_o),
        .wdata2_i(mem_wdata2_o),
        .hi_i(mem_hi_o),
        .lo_i(mem_lo_o),
        .whilo_i(mem_whilo_o),
        .LLbit_i(mem_LLbit_o),
        .LLbit_we_i(mem_LLbit_we_o),
        .cp0_wsel_i(mem_cp0_wsel_o),
        .cp0_we_i(mem_cp0_we_o),
	    .cp0_waddr_i(mem_cp0_waddr_o),
	    .cp0_wdata_i(mem_cp0_wdata_o),
	    .exception_first_inst_i(mem_exception_first_inst_o),
	    .pc_o(commit_pc_o),
        .waddr1_o(rf_waddr1),
        .waddr2_o(rf_waddr2),
        .we1_o(rf_we1),
        .we2_o(rf_we2),
        .wdata1_o(rf_wdata1),
        .wdata2_o(rf_wdata2),
        .hi_o(hi_i),
        .lo_o(lo_i),
        .whilo_o(we_hilo),
        .LLbit_o(LLbit_i),
        .LLbit_we_o(LLbit_we),
        .cp0_wsel_o(cp0_wsel),
        .cp0_we_o(cp0_we),
	    .cp0_waddr_o(cp0_waddr),
	    .cp0_wdata_o(cp0_wdata)
        );
        

    
endmodule
