SocialistDalao/UltraMIPS_Cache/Resource/PastVersion/7.28noon-InstUncached/id_sub.v

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
`include "defines.v"

module id_sub(

	input rst,
	input[`InstAddrBus]   pc_i,
	input[`InstBus]       inst_i,

	input[`RegBus]           reg1_data_i,
	input[`RegBus]           reg2_data_i,
	
	// 解决数据相关
    input[`RegAddrBus]    ex_waddr1_i,
	input[`RegAddrBus]    ex_waddr2_i,
	input                 ex_we1_i,
	input                 ex_we2_i,
	input[`RegBus]        ex_wdata1_i,
	input[`RegBus]        ex_wdata2_i,
	input[`RegAddrBus]    mem_waddr1_i,
	input[`RegAddrBus]    mem_waddr2_i,
	input                 mem_we1_i,
	input                 mem_we2_i,
	input[`RegBus]        mem_wdata1_i,
	input[`RegBus]        mem_wdata2_i,
	
	// 访存相关
	input                 is_load,
	
	// 送到regfile的信息
	output reg                    reg1_read_o,
	output reg                    reg2_read_o,     
	output reg[`RegAddrBus]       reg1_raddr_o,
	output reg[`RegAddrBus]       reg2_raddr_o, 	      
	
	// 送到执行阶段的信息
	output reg[`AluOpBus]         aluop_o,
	output reg[`AluSelBus]        alusel_o,
	output reg[`RegBus]           reg1_o,
	output reg[`RegBus]           reg2_o,
	output reg[`RegAddrBus]       waddr_o,
	output reg                    we_o,
	output reg[`RegAddrBus]       cp0_addr_o,
	
	output[31:0]               exception_type,
	
	// 生成的最终立即数，为跳转/分支指令而准备
	output[`RegBus]            imm_o,
	
	output                     load_dependency
	
);

    wire[5:0] op = inst_i[31:26];
    wire[4:0] rs = inst_i[25:21];
    wire[4:0] rt = inst_i[20:16];
    wire[4:0] rd = inst_i[15:11];
    wire[4:0] shamt = inst_i[10:6];
    wire[5:0] funct = inst_i[5:0];
    wire[15:0] imm = inst_i[15:0];
  
    wire[31:0] imm_zext; // 立即数零扩展
    wire[31:0] imm_sext; // 立即数符号扩展
    wire[31:0] imm_jext; // J型指令立即数扩展，即将指令字段的立即数左移两位并零扩展，与PC拼接的操作将在执行阶段进行
    wire[31:0] imm_bext; // B型指令立即数扩展，即将指令字段的立即数左移两位并符号扩展
  
    reg[`RegBus]	imm_fnl;
    reg instvalid;
    reg reg1_load_dependency;
    reg reg2_load_dependency;
    reg syscall_exception;
    reg eret_exception;
    reg break_exception;
    wire adel_exception;
    wire ri_exception;
    
    assign load_dependency = reg1_load_dependency == `LoadDependent || reg2_load_dependency == `LoadDependent ? `LoadDependent : `LoadIndependent;
    
    assign imm_zext = {16'b0, imm};
    assign imm_sext = {{16{imm[15]}}, imm};
    assign imm_jext = {4'h0, inst_i[25:0], 2'h0};
    assign imm_bext = {{14{imm[15]}}, imm, 2'h0};
    
    assign adel_exception = pc_i[1:0] != 2'b00;
    assign ri_exception = instvalid == `InstInvalid ? 1'b1 : 1'b0;
    
    assign exception_type = {17'b0, eret_exception, 3'b0, ri_exception, break_exception, syscall_exception, 3'b0, adel_exception, 4'b0};
 
    always @ (*) begin	
		if (rst == `RstEnable) begin
			aluop_o = `EXE_NOP_OP;
			alusel_o = `EXE_RES_NOP;
			waddr_o = `NOPRegAddr;
			we_o = `WriteDisable;
			instvalid = `InstValid;
			reg1_read_o = `ReadDisable;
			reg2_read_o = `ReadDisable;
			reg1_raddr_o = `NOPRegAddr;
			reg2_raddr_o = `NOPRegAddr;
			imm_fnl = 32'h0;
			cp0_addr_o = 5'b00000;
			syscall_exception = 1'b0;
			eret_exception = 1'b0;
			break_exception = 1'b0;
        end else begin
			aluop_o = `EXE_NOP_OP;
			alusel_o = `EXE_RES_NOP;
			waddr_o = rd;
			we_o = `WriteDisable;
			instvalid = `InstInvalid;
			reg1_read_o = `ReadDisable;
			reg2_read_o = `ReadDisable;
			reg1_raddr_o = rs;
			reg2_raddr_o = rt;	
			imm_fnl = `ZeroWord;
			cp0_addr_o = 5'b00000;
			syscall_exception = 1'b0;
			eret_exception = 1'b0;
			break_exception = 1'b0;
		  case (op)
		  `EXE_SPECIAL_INST: begin
		      if (shamt == 5'b00000) begin
		          case (funct)
		              `EXE_OR: begin
		                  we_o = `WriteEnable;
		                  aluop_o = `EXE_OR_OP;
		                  alusel_o = `EXE_RES_LOGIC;
		                  reg1_read_o = `ReadEnable;
		                  reg2_read_o = `ReadEnable;
		                  instvalid = `InstValid;
		              end
		              `EXE_AND: begin
		                  we_o = `WriteEnable;
		                  aluop_o = `EXE_AND_OP;
		                  alusel_o = `EXE_RES_LOGIC;
		                  reg1_read_o = `ReadEnable;
		                  reg2_read_o = `ReadEnable;
		                  instvalid = `InstValid;
		              end
		              `EXE_XOR: begin
		                  we_o = `WriteEnable;
		                  aluop_o = `EXE_XOR_OP;
		                  alusel_o = `EXE_RES_LOGIC;
		                  reg1_read_o = `ReadEnable;
		                  reg2_read_o = `ReadEnable;
		                  instvalid = `InstValid;
		              end
		              `EXE_NOR: begin
		                  we_o = `WriteEnable;
		                  aluop_o = `EXE_NOR_OP;
		                  alusel_o = `EXE_RES_LOGIC;
		                  reg1_read_o = `ReadEnable;
		                  reg2_read_o = `ReadEnable;
		                  instvalid = `InstValid;
		              end
		              `EXE_SLLV: begin
		                  we_o = `WriteEnable;
		                  aluop_o = `EXE_SLL_OP;
		                  alusel_o = `EXE_RES_SHIFT;
		                  reg1_read_o = `ReadEnable;
		                  reg2_read_o = `ReadEnable;
		                  instvalid = `InstValid;
		              end
		              `EXE_SRLV: begin
		                  we_o = `WriteEnable;
		                  aluop_o = `EXE_SRL_OP;
		                  alusel_o = `EXE_RES_SHIFT;
		                  reg1_read_o = `ReadEnable;
		                  reg2_read_o = `ReadEnable;
		                  instvalid = `InstValid;
		              end
		              `EXE_SRAV: begin
		                  we_o = `WriteEnable;
		                  aluop_o = `EXE_SRA_OP;
		                  alusel_o = `EXE_RES_SHIFT;
		                  reg1_read_o = `ReadEnable;
		                  reg2_read_o = `ReadEnable;
		                  instvalid = `InstValid;
		              end
		              `EXE_MFHI: begin
                          we_o = `WriteEnable;
                          aluop_o = `EXE_MFHI_OP;
                          alusel_o = `EXE_RES_MOVE;
                          reg1_read_o = 1'b0;
                          reg2_read_o = 1'b0;
                          instvalid = `InstValid;	
                      end
                      `EXE_MFLO: begin
                          we_o = `WriteEnable;
                          aluop_o = `EXE_MFLO_OP;
                          alusel_o = `EXE_RES_MOVE;
                          reg1_read_o = 1'b0;
                          reg2_read_o = 1'b0;
                          instvalid = `InstValid;	
                      end
                      `EXE_MTHI: begin
                          we_o = `WriteDisable;
                          aluop_o = `EXE_MTHI_OP;
                          reg1_read_o = 1'b1;
                          reg2_read_o = 1'b0;
                          instvalid = `InstValid;	
                      end
                      `EXE_MTLO: begin
                          we_o = `WriteEnable;
                          aluop_o = `EXE_MTLO_OP;
                          reg1_read_o = 1'b1;
                          reg2_read_o = 1'b0;
                          instvalid = `InstValid;	
                      end
                      // 条件移动由于ID的两个子部件存在相关问题，所以不能在此处立刻判断，因此先默认条件满足，再在执行阶段进行进一步判断
                      `EXE_MOVN: begin
                          we_o = `WriteEnable;
                          aluop_o = `EXE_MOVN_OP;
                          alusel_o = `EXE_RES_MOVE;
                          reg1_read_o = `ReadEnable;
                          reg2_read_o = `ReadEnable;
                          instvalid = `InstValid;
                      end
                      `EXE_MOVZ: begin
                          we_o = `WriteEnable;
                          aluop_o = `EXE_MOVZ_OP;
                          alusel_o = `EXE_RES_MOVE;
                          reg1_read_o = `ReadEnable;
                          reg2_read_o = `ReadEnable;
                          instvalid = `InstValid;
                      end
                      `EXE_SLT: begin
                          we_o = `WriteEnable;
                          aluop_o = `EXE_SLT_OP;
                          alusel_o = `EXE_RES_ARITHMETIC;
                          reg1_read_o = `ReadEnable;
                          reg2_read_o = `ReadEnable;
                          instvalid = `InstValid;
                      end
                      `EXE_SLTU: begin
                          we_o = `WriteEnable;
                          aluop_o = `EXE_SLTU_OP;
                          alusel_o = `EXE_RES_ARITHMETIC;
                          reg1_read_o = `ReadEnable;
                          reg2_read_o = `ReadEnable;
                          instvalid = `InstValid;
                      end
                      `EXE_ADD: begin
                          we_o = `WriteEnable;
                          aluop_o = `EXE_ADD_OP;
                          alusel_o = `EXE_RES_ARITHMETIC;
                          reg1_read_o = `ReadEnable;
                          reg2_read_o = `ReadEnable;
                          instvalid = `InstValid;
                      end
                      `EXE_ADDU: begin
                          we_o = `WriteEnable;
                          aluop_o = `EXE_ADDU_OP;
                          alusel_o = `EXE_RES_ARITHMETIC;
                          reg1_read_o = `ReadEnable;
                          reg2_read_o = `ReadEnable;
                          instvalid = `InstValid;
                      end
                      `EXE_SUB: begin
                          we_o = `WriteEnable;
                          aluop_o = `EXE_SUB_OP;
                          alusel_o = `EXE_RES_ARITHMETIC;
                          reg1_read_o = `ReadEnable;
                          reg2_read_o = `ReadEnable;
                          instvalid = `InstValid;
                      end
                      `EXE_SUBU: begin
                          we_o = `WriteEnable;
                          aluop_o = `EXE_SUBU_OP;
                          alusel_o = `EXE_RES_ARITHMETIC;
                          reg1_read_o = `ReadEnable;
                          reg2_read_o = `ReadEnable;
                          instvalid = `InstValid;
                      end
                      `EXE_MULT: begin
                          we_o = `WriteDisable;
                          aluop_o = `EXE_MULT_OP;
                          reg1_read_o = `ReadEnable;
                          reg2_read_o = `ReadEnable;
                          instvalid = `InstValid;
                      end
                      `EXE_MULTU: begin
                          we_o = `WriteDisable;
                          aluop_o = `EXE_MULTU_OP;
                          reg1_read_o = `ReadEnable;
                          reg2_read_o = `ReadEnable;
                          instvalid = `InstValid;
                      end
                      `EXE_DIV: begin
                          we_o = `WriteDisable;
                          aluop_o = `EXE_DIV_OP;
                          reg1_read_o = `ReadEnable;
                          reg2_read_o = `ReadEnable;
                          instvalid = `InstValid;
                      end
                      `EXE_DIVU: begin
                          we_o = `WriteDisable;
                          aluop_o = `EXE_DIVU_OP;
                          reg1_read_o = `ReadEnable;
                          reg2_read_o = `ReadEnable;
                          instvalid = `InstValid;
                      end
                      `EXE_JR: begin
                          we_o = `WriteDisable;
                          aluop_o = `EXE_JR_OP;
                          alusel_o = `EXE_RES_JUMP_BRANCH;
                          reg1_read_o = `ReadEnable;
                          reg2_read_o = `ReadDisable;
                          instvalid = `InstValid;
                      end
                      `EXE_JALR: begin
                          we_o = `WriteEnable;
                          aluop_o = `EXE_JALR_OP;
                          alusel_o = `EXE_RES_JUMP_BRANCH;
                          reg1_read_o = `ReadEnable;
                          reg2_read_o = `ReadDisable;
                          instvalid = `InstValid;
                      end
		              `EXE_SYNC: begin
		                  we_o = `WriteDisable;
		                  aluop_o = `EXE_NOP_OP;
		                  alusel_o = `EXE_RES_NOP;
		                  reg1_read_o = `ReadDisable;
		                  reg2_read_o = `ReadEnable;
		                  instvalid = `InstValid;
		              end
		              default: ;
		          endcase
		      end
		      case (funct)
		          `EXE_TEQ: begin
		              we_o = `WriteDisable;
		              aluop_o = `EXE_TEQ_OP;
		              alusel_o = `EXE_RES_NOP;
		              reg1_read_o = `ReadEnable;
		              reg2_read_o = `ReadEnable;
		              instvalid = `InstValid;
		          end
		          `EXE_TGE: begin
		              we_o = `WriteDisable;
		              aluop_o = `EXE_TGE_OP;
		              alusel_o = `EXE_RES_NOP;
		              reg1_read_o = `ReadEnable;
		              reg2_read_o = `ReadEnable;
		              instvalid = `InstValid;
		          end
		          `EXE_TGEU: begin
		              we_o = `WriteDisable;
		              aluop_o = `EXE_TGEU_OP;
		              alusel_o = `EXE_RES_NOP;
		              reg1_read_o = `ReadEnable;
		              reg2_read_o = `ReadEnable;
		              instvalid = `InstValid;
		          end
		          `EXE_TLT: begin
		              we_o = `WriteDisable;
		              aluop_o = `EXE_TLT_OP;
		              alusel_o = `EXE_RES_NOP;
		              reg1_read_o = `ReadEnable;
		              reg2_read_o = `ReadEnable;
		              instvalid = `InstValid;
		          end
		          `EXE_TLTU: begin
		              we_o = `WriteDisable;
		              aluop_o = `EXE_TLTU_OP;
		              alusel_o = `EXE_RES_NOP;
		              reg1_read_o = `ReadEnable;
		              reg2_read_o = `ReadEnable;
		              instvalid = `InstValid;
		          end
		          `EXE_TNE: begin
		              we_o = `WriteDisable;
		              aluop_o = `EXE_TNE_OP;
		              alusel_o = `EXE_RES_NOP;
		              reg1_read_o = `ReadEnable;
		              reg2_read_o = `ReadEnable;
		              instvalid = `InstValid;
		          end
		          `EXE_BREAK: begin
		              we_o = `WriteDisable;
		              aluop_o = `EXE_BREAK_OP;
		              alusel_o = `EXE_RES_NOP;
		              reg1_read_o = `ReadDisable;
		              reg2_read_o = `ReadDisable;
		              instvalid = `InstValid;
		              break_exception = 1'b1;
		          end
		          `EXE_SYSCALL: begin
		              we_o = `WriteDisable;
		              aluop_o = `EXE_SYSCALL_OP;
		              alusel_o = `EXE_RES_NOP;
		              reg1_read_o = `ReadDisable;
		              reg2_read_o = `ReadDisable;
		              instvalid = `InstValid;
		              syscall_exception = 1'b1;
		          end
		          default: ;
		      endcase
		      if (rs == 5'b00000) begin
		          case (funct)
		          `EXE_SLL: begin
		              we_o = `WriteEnable;
		              aluop_o = `EXE_SLL_OP;
		              alusel_o = `EXE_RES_SHIFT;
		              reg1_read_o = `ReadDisable;
		              reg2_read_o = `ReadEnable;
		              imm_fnl = shamt;
		              instvalid = `InstValid;
		          end
		          `EXE_SRL: begin
		              we_o = `WriteEnable;
		              aluop_o = `EXE_SRL_OP;
		              alusel_o = `EXE_RES_SHIFT;
		              reg1_read_o = `ReadDisable;
		              reg2_read_o = `ReadEnable;
		              imm_fnl = shamt;
		              instvalid = `InstValid;
		          end
		          `EXE_SRA: begin
		              we_o = `WriteEnable;
		              aluop_o = `EXE_SRA_OP;
		              alusel_o = `EXE_RES_SHIFT;
		              reg1_read_o = `ReadDisable;
		              reg2_read_o = `ReadEnable;
		              imm_fnl = shamt;
		              instvalid = `InstValid;
		          end
		          default: ;
		          endcase
		      end
		  end
		  `EXE_ORI: begin
              aluop_o = `EXE_OR_OP;
              alusel_o = `EXE_RES_LOGIC;
              waddr_o = rt;
              we_o = `WriteEnable;
              instvalid = `InstValid;
              reg1_read_o = `ReadEnable;
              reg2_read_o = `ReadDisable;	  	
              imm_fnl = imm_zext;
          end
          `EXE_ANDI: begin
              aluop_o = `EXE_AND_OP;
              alusel_o = `EXE_RES_LOGIC;
              waddr_o = rt;
              we_o = `WriteEnable;
              instvalid = `InstValid;
              reg1_read_o = `ReadEnable;
              reg2_read_o = `ReadDisable;	  	
              imm_fnl = imm_zext;
          end
          `EXE_XORI: begin
              aluop_o = `EXE_XOR_OP;
              alusel_o = `EXE_RES_LOGIC;
              waddr_o = rt;
              we_o = `WriteEnable;
              instvalid = `InstValid;
              reg1_read_o = `ReadEnable;
              reg2_read_o = `ReadDisable;	  	
              imm_fnl = imm_zext;
          end
          `EXE_LUI: begin
              aluop_o = `EXE_OR_OP;
              alusel_o = `EXE_RES_LOGIC;
              waddr_o = rt;
              we_o = `WriteEnable;
              instvalid = `InstValid;
              reg1_read_o = `ReadEnable;
              reg2_read_o = `ReadDisable;	  	
              imm_fnl = {imm, 16'h0};
          end
          `EXE_SLTI: begin
              aluop_o = `EXE_SLT_OP;
              alusel_o = `EXE_RES_ARITHMETIC;
              waddr_o = rt;
              we_o = `WriteEnable;
              instvalid = `InstValid;
              reg1_read_o = `ReadEnable;
              reg2_read_o = `ReadDisable;
              imm_fnl = imm_sext;
          end
          `EXE_SLTIU: begin
              aluop_o = `EXE_SLTU_OP;
              alusel_o = `EXE_RES_ARITHMETIC;
              waddr_o = rt;
              we_o = `WriteEnable;
              instvalid = `InstValid;
              reg1_read_o = `ReadEnable;
              reg2_read_o = `ReadDisable;
              imm_fnl = imm_sext;
          end
          `EXE_ADDI: begin
              aluop_o = `EXE_ADDI_OP;
              alusel_o = `EXE_RES_ARITHMETIC;
              waddr_o = rt;
              we_o = `WriteEnable;
              instvalid = `InstValid;
              reg1_read_o = `ReadEnable;
              reg2_read_o = `ReadDisable;
              imm_fnl = imm_sext;
          end
          `EXE_ADDIU: begin
              aluop_o = `EXE_ADDIU_OP;
              alusel_o = `EXE_RES_ARITHMETIC;
              waddr_o = rt;
              we_o = `WriteEnable;
              instvalid = `InstValid;
              reg1_read_o = `ReadEnable;
              reg2_read_o = `ReadDisable;
              imm_fnl = imm_sext;
          end
          `EXE_J: begin
              aluop_o = `EXE_J_OP;
              alusel_o = `EXE_RES_JUMP_BRANCH;
              we_o = `WriteDisable;
              instvalid = `InstValid;
              reg1_read_o = `ReadDisable;
              reg2_read_o = `ReadDisable;
              imm_fnl = imm_jext;
          end
          `EXE_JAL: begin
              aluop_o = `EXE_JAL_OP;
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
          end
          `EXE_SH: begin
              aluop_o = `EXE_SH_OP;
              alusel_o = `EXE_RES_LOAD_STORE;
              we_o = `WriteDisable;
              instvalid = `InstValid;
              reg1_read_o = `ReadEnable;
              reg2_read_o = `ReadEnable;
              imm_fnl = imm_sext;
          end
          `EXE_SW: begin
              aluop_o = `EXE_SW_OP;
              alusel_o = `EXE_RES_LOAD_STORE;
              we_o = `WriteDisable;
              instvalid = `InstValid;
              reg1_read_o = `ReadEnable;
              reg2_read_o = `ReadEnable;
              imm_fnl = imm_sext;
          end
          `EXE_SWL: begin
              aluop_o = `EXE_SWL_OP;
              alusel_o = `EXE_RES_LOAD_STORE;
              we_o = `WriteDisable;
              instvalid = `InstValid;
              reg1_read_o = `ReadEnable;
              reg2_read_o = `ReadEnable;
              imm_fnl = imm_sext;
          end
          `EXE_SWR: begin
              aluop_o = `EXE_SWR_OP;
              alusel_o = `EXE_RES_LOAD_STORE;
              we_o = `WriteDisable;
              instvalid = `InstValid;
              reg1_read_o = `ReadEnable;
              reg2_read_o = `ReadEnable;
              imm_fnl = imm_sext;
          end
          `EXE_LL: begin
              aluop_o = `EXE_LL_OP;
              alusel_o = `EXE_RES_LOAD_STORE;
              waddr_o = rt;
              we_o = `WriteEnable;
              instvalid = `InstValid;
              reg1_read_o = `ReadEnable;
              reg2_read_o = `ReadDisable;
              imm_fnl = imm_sext;
          end
          `EXE_SC: begin
              aluop_o = `EXE_SC_OP;
              alusel_o = `EXE_RES_LOAD_STORE;
              waddr_o = rt;
              we_o = `WriteEnable;
              instvalid = `InstValid;
              reg1_read_o = `ReadEnable;
              reg2_read_o = `ReadEnable;
              imm_fnl = imm_sext;
          end
          `EXE_PREF: begin
              aluop_o = `EXE_NOP_OP;
              alusel_o = `EXE_RES_NOP;
              we_o = `WriteDisable;
              instvalid = `InstValid;
              reg1_read_o = `ReadDisable;
              reg2_read_o = `ReadDisable;
          end
          `EXE_REGIMM_INST: begin
              case(rt)
                  `EXE_BGEZ: begin
                      aluop_o = `EXE_BGEZ_OP;
                      alusel_o = `EXE_RES_JUMP_BRANCH;
                      we_o = `WriteDisable;
                      instvalid = `InstValid;
                      reg1_read_o = `ReadEnable;
                      reg2_read_o = `ReadDisable;
                      imm_fnl = imm_bext;
                  end
                  `EXE_BGEZAL: begin
                      aluop_o = `EXE_BGEZAL_OP;
                      alusel_o = `EXE_RES_JUMP_BRANCH;
                      waddr_o = 5'b11111;
                      we_o = `WriteEnable;
                      instvalid = `InstValid;
                      reg1_read_o = `ReadEnable;
                      reg2_read_o = `ReadDisable;
                      imm_fnl = imm_bext;
                  end
                  `EXE_BLTZ: begin
                      aluop_o = `EXE_BLTZ_OP;
                      alusel_o = `EXE_RES_JUMP_BRANCH;
                      we_o = `WriteDisable;
                      instvalid = `InstValid;
                      reg1_read_o = `ReadEnable;
                      reg2_read_o = `ReadDisable;
                      imm_fnl = imm_bext;
                  end
                  `EXE_BLTZAL: begin
                      aluop_o = `EXE_BLTZAL_OP;
                      alusel_o = `EXE_RES_JUMP_BRANCH;
                      waddr_o = 5'b11111;
                      we_o = `WriteEnable;
                      instvalid = `InstValid;
                      reg1_read_o = `ReadEnable;
                      reg2_read_o = `ReadDisable;
                      imm_fnl = imm_bext;
                  end
                  `EXE_TEQI: begin
                      aluop_o = `EXE_TEQI_OP;
                      alusel_o = `EXE_RES_NOP;
                      we_o = `WriteDisable;
                      instvalid = `InstValid;
                      reg1_read_o = `ReadEnable;
                      reg2_read_o = `ReadDisable;
                      imm_fnl = imm_sext;
                  end
                  `EXE_TGEI: begin
                      aluop_o = `EXE_TGEI_OP;
                      alusel_o = `EXE_RES_NOP;
                      we_o = `WriteDisable;
                      instvalid = `InstValid;
                      reg1_read_o = `ReadEnable;
                      reg2_read_o = `ReadDisable;
                      imm_fnl = imm_sext;
                  end
                  `EXE_TGEIU: begin
                      aluop_o = `EXE_TGEIU_OP;
                      alusel_o = `EXE_RES_NOP;
                      we_o = `WriteDisable;
                      instvalid = `InstValid;
                      reg1_read_o = `ReadEnable;
                      reg2_read_o = `ReadDisable;
                      imm_fnl = imm_sext;
                  end
                  `EXE_TLTI: begin
                      aluop_o = `EXE_TLTI_OP;
                      alusel_o = `EXE_RES_NOP;
                      we_o = `WriteDisable;
                      instvalid = `InstValid;
                      reg1_read_o = `ReadEnable;
                      reg2_read_o = `ReadDisable;
                      imm_fnl = imm_sext;
                  end
                  `EXE_TLTIU: begin
                      aluop_o = `EXE_TLTIU_OP;
                      alusel_o = `EXE_RES_NOP;
                      we_o = `WriteDisable;
                      instvalid = `InstValid;
                      reg1_read_o = `ReadEnable;
                      reg2_read_o = `ReadDisable;
                      imm_fnl = imm_sext;
                  end
                  `EXE_TNEI: begin
                      aluop_o = `EXE_TNEI_OP;
                      alusel_o = `EXE_RES_NOP;
                      we_o = `WriteDisable;
                      instvalid = `InstValid;
                      reg1_read_o = `ReadEnable;
                      reg2_read_o = `ReadDisable;
                      imm_fnl = imm_sext;
                  end
                  default: ;
              endcase
          end
          `EXE_SPECIAL2_INST: begin
              case (funct)
              /*
              `EXE_CLZ: begin
                  aluop_o = `EXE_CLZ_OP;
                  alusel_o = `EXE_RES_ARITHMETIC;
                  we_o = `WriteEnable;
                  instvalid = `InstValid;
                  reg1_read_o = `ReadEnable;
                  reg2_read_o = `ReadDisable;
              end
              `EXE_CLO: begin
                  aluop_o = `EXE_CLO_OP;
                  alusel_o = `EXE_RES_ARITHMETIC;
                  we_o = `WriteEnable;
                  instvalid = `InstValid;
                  reg1_read_o = `ReadEnable;
                  reg2_read_o = `ReadDisable;
              end
              */
              `EXE_MUL: begin
                  we_o = `WriteEnable;
                  aluop_o = `EXE_MUL_OP;
                  alusel_o = `EXE_RES_MUL;
                  reg1_read_o = `ReadEnable;
                  reg2_read_o = `ReadEnable;
                  instvalid = `InstValid;
              end
              /*
              `EXE_MADD: begin
                  we_o = `WriteEnable;
                  aluop_o = `EXE_MADD_OP;
                  alusel_o = `EXE_RES_MUL;
                  reg1_read_o = `ReadEnable;
                  reg2_read_o = `ReadEnable;
                  instvalid = `InstValid;
              end
              `EXE_MADDU: begin
                  we_o = `WriteEnable;
                  aluop_o = `EXE_MADDU_OP;
                  alusel_o = `EXE_RES_MUL;
                  reg1_read_o = `ReadEnable;
                  reg2_read_o = `ReadEnable;
                  instvalid = `InstValid;
              end
              `EXE_MSUB: begin
                  we_o = `WriteEnable;
                  aluop_o = `EXE_MSUB_OP;
                  alusel_o = `EXE_RES_MUL;
                  reg1_read_o = `ReadEnable;
                  reg2_read_o = `ReadEnable;
                  instvalid = `InstValid;
              end
              `EXE_MSUBU: begin
                  we_o = `WriteEnable;
                  aluop_o = `EXE_MSUBU_OP;
                  alusel_o = `EXE_RES_MUL;
                  reg1_read_o = `ReadEnable;
                  reg2_read_o = `ReadEnable;
                  instvalid = `InstValid;
              end
              */
              default: begin
              end
              endcase
          end
          `EXE_COP0: begin
              if (inst_i[25:21] == 5'b00000 && inst_i[10:3] == 8'b00000000) begin
                  aluop_o = `EXE_MFC0_OP;
                  alusel_o = `EXE_RES_MOVE;
                  waddr_o = rt;
                  we_o = `WriteEnable;
				  instvalid = `InstValid;
                  reg1_read_o = `ReadDisable;
                  reg2_read_o = `ReadDisable;
                  cp0_addr_o = rd;
		      end else if(inst_i[25:21] == 5'b00100 && inst_i[10:3] == 8'b00000000) begin
                  aluop_o = `EXE_MTC0_OP;
                  alusel_o = `EXE_RES_NOP;
                  we_o = `WriteDisable;
                  instvalid = `InstValid;	   
                  reg1_read_o = `ReadEnable;
                  reg1_raddr_o = rt;
                  reg2_read_o = `ReadDisable;
                  cp0_addr_o = rd;				
              end
          end
          default: ;
		  endcase
		  if (inst_i == `EXE_ERET) begin
		      aluop_o = `EXE_ERET_OP;
		      alusel_o = `EXE_RES_NOP;
		      we_o = `WriteDisable;
		      reg1_read_o = `ReadDisable;
              reg2_read_o = `ReadDisable;
              instvalid = `InstValid;
              eret_exception = 1'b1;
		  end
	    end
    end
	

	always @ (*) begin
	    reg1_o = `ZeroWord;
	    reg1_load_dependency = `LoadIndependent;
        if (rst == `RstEnable) reg1_o = `ZeroWord;
        else if (reg1_read_o == `ReadEnable)
            if (is_load && ex_waddr1_i == reg1_raddr_o) reg1_load_dependency = `LoadDependent;
            else if (ex_we2_i == `WriteEnable && ex_waddr2_i == reg1_raddr_o) reg1_o = ex_wdata2_i;
            else if (ex_we1_i == `WriteEnable && ex_waddr1_i == reg1_raddr_o) reg1_o = ex_wdata1_i;
            else if (mem_we2_i == `WriteEnable && mem_waddr2_i == reg1_raddr_o) reg1_o = mem_wdata2_i;
            else if (mem_we1_i == `WriteEnable && mem_waddr1_i == reg1_raddr_o) reg1_o = mem_wdata1_i;
            else reg1_o = reg1_data_i;
        else if (reg1_read_o == `ReadDisable) reg1_o = imm_fnl;
        else reg1_o = `ZeroWord;
    end
    
    always @ (*) begin
        reg2_o = `ZeroWord;
        reg2_load_dependency = `LoadIndependent;
        if (rst == `RstEnable) reg2_o = `ZeroWord;
        else if (reg2_read_o == `ReadEnable)
            if (is_load && ex_waddr1_i == reg2_raddr_o) reg2_load_dependency = `LoadDependent;
            else if (ex_we2_i == `WriteEnable && ex_waddr2_i == reg2_raddr_o) reg2_o = ex_wdata2_i;
            else if (ex_we1_i == `WriteEnable && ex_waddr1_i == reg2_raddr_o) reg2_o = ex_wdata1_i;
            else if (mem_we2_i == `WriteEnable && mem_waddr2_i == reg2_raddr_o) reg2_o = mem_wdata2_i;
            else if (mem_we1_i == `WriteEnable && mem_waddr1_i == reg2_raddr_o) reg2_o = mem_wdata1_i;
            else reg2_o = reg2_data_i;
        else if (reg2_read_o == `ReadDisable) reg2_o = imm_fnl;
        else reg2_o = `ZeroWord;
    end
    
    assign imm_o = imm_fnl;

endmodule
