SocialistDalao/UltraMIPS_Cache/Resource/PastVersion/7.28noon-InstUncached/fa64.v

//////////////////////////////////////////////////////////////////////////////////
// Company: 
// Engineer: 
// 
// Create Date: 2020/07/26 11:35:11
// Design Name: 
// Module Name: fa64
// Project Name: 
// Target Devices: 
// Tool Versions: 
// Description: 
// 
// Dependencies: 
// 
// Revision:
// Revision 0.01 - File Created
// Additional Comments:
// 
//////////////////////////////////////////////////////////////////////////////////


module fa64(
    input[63:0] a,
    input[63:0] b,
    input cin,
    input sub,
    output[63:0] s,
    output[63:0] cout
    );
    wire[63:0] b_in;
    wire cin_in;
    wire[3:0] p;
    wire[3:0] g;
    wire[3:0] c;
    assign b_in = sub ? ~b : b;
    assign cin_in = sub ^ cin;
    fa16 u_fa160(.a(a[15:0]), .b(b_in[15:0]), .cin(cin_in), .gout(g[0]), .pout(p[0]), .s(s[15:0]), .cout(cout[15:0]));
    fa16 u_fa161(.a(a[31:16]), .b(b_in[31:16]), .cin(c[0]), .gout(g[1]), .pout(p[1]), .s(s[31:16]), .cout(cout[31:16]));
    fa16 u_fa162(.a(a[47:32]), .b(b_in[47:32]), .cin(c[1]), .gout(g[2]), .pout(p[2]), .s(s[47:32]), .cout(cout[47:32]));
    fa16 u_fa163(.a(a[63:48]), .b(b_in[63:48]), .cin(c[2]), .gout(g[3]), .pout(p[3]), .s(s[63:48]), .cout(cout[63:48]));
    cla u_cla(.p(p), .g(g), .cin(cin), .cout(c));
endmodule
