SocialistDalao/UltraMIPS_Cache/Resource/pref_pass_49/myCPU/bank_ram/bank_ram_stub.v

// Copyright 1986-2019 Xilinx, Inc. All Rights Reserved.
// --------------------------------------------------------------------------------
// Tool Version: Vivado v.2019.2 (win64) Build 2708876 Wed Nov  6 21:40:23 MST 2019
// Date        : Wed Jul 22 16:26:29 2020
// Host        : DESKTOP-9PFR4SB running 64-bit major release  (build 9200)
// Command     : write_verilog -force -mode synth_stub
//               C:/Users/Eobard/Desktop/cpu/nscscc2020_group_v0.01/nscscc2020_group_v0.01/func_test_v0.01/soc_axi_func/rtl/myCPU/bank_ram/bank_ram_stub.v
// Design      : bank_ram
// Purpose     : Stub declaration of top-level module interface
// Device      : xc7a200tfbg676-2
// --------------------------------------------------------------------------------

// This empty module with port declaration file causes synthesis tools to infer a black box for IP.
// The synthesis directives are for Synopsys Synplify support to prevent IO buffer insertion.
// Please paste the declaration into a Verilog source file or add the file as an additional source.
(* x_core_info = "blk_mem_gen_v8_4_4,Vivado 2019.2" *)
module bank_ram(clka, ena, wea, addra, dina, douta)
/* synthesis syn_black_box black_box_pad_pin="clka,ena,wea[3:0],addra[6:0],dina[31:0],douta[31:0]" */;
  input clka;
  input ena;
  input [3:0]wea;
  input [6:0]addra;
  input [31:0]dina;
  output [31:0]douta;
endmodule
