SocialistDalao/UltraMIPS_Cache/ICache.cache/ip/2019.2/85fc76a1d9148bf6/clk_wiz_0_stub.vhdl

-- Copyright 1986-2019 Xilinx, Inc. All Rights Reserved.
-- --------------------------------------------------------------------------------
-- Tool Version: Vivado v.2019.2 (win64) Build 2708876 Wed Nov  6 21:40:23 MST 2019
-- Date        : Tue Jun 30 17:21:39 2020
-- Host        : DESKTOP-DE0831E running 64-bit major release  (build 9200)
-- Command     : write_vhdl -force -mode synth_stub -rename_top decalper_eb_ot_sdeen_pot_pi_dehcac_xnilix -prefix
--               decalper_eb_ot_sdeen_pot_pi_dehcac_xnilix_ clk_wiz_0_stub.vhdl
-- Design      : clk_wiz_0
-- Purpose     : Stub declaration of top-level module interface
-- Device      : xc7a200tfbg676-2
-- --------------------------------------------------------------------------------
library IEEE;
use IEEE.STD_LOGIC_1164.ALL;

entity decalper_eb_ot_sdeen_pot_pi_dehcac_xnilix is
  Port ( 
    clk_out1 : out STD_LOGIC;
    clk_in1 : in STD_LOGIC
  );

end decalper_eb_ot_sdeen_pot_pi_dehcac_xnilix;

architecture stub of decalper_eb_ot_sdeen_pot_pi_dehcac_xnilix is
attribute syn_black_box : boolean;
attribute black_box_pad_pin : string;
attribute syn_black_box of stub : architecture is true;
attribute black_box_pad_pin of stub : architecture is "clk_out1,clk_in1";
begin
end;
