SocialistDalao/UltraMIPS_Cache/Resource/pref_pass_49/myCPU/simple_dual_ram/simple_dual_ram_sim_netlist.vhdl

-- Copyright 1986-2019 Xilinx, Inc. All Rights Reserved.
-- --------------------------------------------------------------------------------
-- Tool Version: Vivado v.2019.2 (win64) Build 2708876 Wed Nov  6 21:40:23 MST 2019
-- Date        : Tue Jul 28 10:18:46 2020
-- Host        : DESKTOP-KQ0TA7J running 64-bit major release  (build 9200)
-- Command     : write_vhdl -force -mode funcsim
--               C:/Users/LENOVO/Desktop/perf_test_v0.02/perf_test_v0.01/soc_axi_perf/rtl/myCPU/simple_dual_ram/simple_dual_ram_sim_netlist.vhdl
-- Design      : simple_dual_ram
-- Purpose     : This VHDL netlist is a functional simulation representation of the design and should not be modified or
--               synthesized. This netlist cannot be used for SDF annotated simulation.
-- Device      : xc7a200tfbg676-2
-- --------------------------------------------------------------------------------
library IEEE;
use IEEE.STD_LOGIC_1164.ALL;
library UNISIM;
use UNISIM.VCOMPONENTS.ALL;
entity simple_dual_ram_blk_mem_gen_prim_wrapper is
  port (
    doutb : out STD_LOGIC_VECTOR ( 31 downto 0 );
    clka : in STD_LOGIC;
    enb : in STD_LOGIC;
    ena : in STD_LOGIC;
    addrb : in STD_LOGIC_VECTOR ( 6 downto 0 );
    addra : in STD_LOGIC_VECTOR ( 6 downto 0 );
    dina : in STD_LOGIC_VECTOR ( 31 downto 0 );
    wea : in STD_LOGIC_VECTOR ( 3 downto 0 )
  );
  attribute ORIG_REF_NAME : string;
  attribute ORIG_REF_NAME of simple_dual_ram_blk_mem_gen_prim_wrapper : entity is "blk_mem_gen_prim_wrapper";
end simple_dual_ram_blk_mem_gen_prim_wrapper;

architecture STRUCTURE of simple_dual_ram_blk_mem_gen_prim_wrapper is
  signal \DEVICE_7SERIES.NO_BMM_INFO.SDP.WIDE_PRIM18.ram_n_32\ : STD_LOGIC;
  signal \DEVICE_7SERIES.NO_BMM_INFO.SDP.WIDE_PRIM18.ram_n_33\ : STD_LOGIC;
  signal \DEVICE_7SERIES.NO_BMM_INFO.SDP.WIDE_PRIM18.ram_n_34\ : STD_LOGIC;
  signal \DEVICE_7SERIES.NO_BMM_INFO.SDP.WIDE_PRIM18.ram_n_35\ : STD_LOGIC;
  attribute box_type : string;
  attribute box_type of \DEVICE_7SERIES.NO_BMM_INFO.SDP.WIDE_PRIM18.ram\ : label is "PRIMITIVE";
begin
\DEVICE_7SERIES.NO_BMM_INFO.SDP.WIDE_PRIM18.ram\: unisim.vcomponents.RAMB18E1
    generic map(
      DOA_REG => 0,
      DOB_REG => 0,
      INITP_00 => X"0000000000000000000000000000000000000000000000000000000000000000",
      INITP_01 => X"0000000000000000000000000000000000000000000000000000000000000000",
      INITP_02 => X"0000000000000000000000000000000000000000000000000000000000000000",
      INITP_03 => X"0000000000000000000000000000000000000000000000000000000000000000",
      INITP_04 => X"0000000000000000000000000000000000000000000000000000000000000000",
      INITP_05 => X"0000000000000000000000000000000000000000000000000000000000000000",
      INITP_06 => X"0000000000000000000000000000000000000000000000000000000000000000",
      INITP_07 => X"0000000000000000000000000000000000000000000000000000000000000000",
      INIT_00 => X"0000000000000000000000000000000000000000000000000000000000000000",
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
      INIT_32 => X"0000000000000000000000000000000000000000000000000000000000000000",
      INIT_33 => X"0000000000000000000000000000000000000000000000000000000000000000",
      INIT_34 => X"0000000000000000000000000000000000000000000000000000000000000000",
      INIT_35 => X"0000000000000000000000000000000000000000000000000000000000000000",
      INIT_36 => X"0000000000000000000000000000000000000000000000000000000000000000",
      INIT_37 => X"0000000000000000000000000000000000000000000000000000000000000000",
      INIT_38 => X"0000000000000000000000000000000000000000000000000000000000000000",
      INIT_39 => X"0000000000000000000000000000000000000000000000000000000000000000",
      INIT_3A => X"0000000000000000000000000000000000000000000000000000000000000000",
      INIT_3B => X"0000000000000000000000000000000000000000000000000000000000000000",
      INIT_3C => X"0000000000000000000000000000000000000000000000000000000000000000",
      INIT_3D => X"0000000000000000000000000000000000000000000000000000000000000000",
      INIT_3E => X"0000000000000000000000000000000000000000000000000000000000000000",
      INIT_3F => X"0000000000000000000000000000000000000000000000000000000000000000",
      INIT_A => X"00000",
      INIT_B => X"00000",
      INIT_FILE => "NONE",
      IS_CLKARDCLK_INVERTED => '0',
      IS_CLKBWRCLK_INVERTED => '0',
      IS_ENARDEN_INVERTED => '0',
      IS_ENBWREN_INVERTED => '0',
      IS_RSTRAMARSTRAM_INVERTED => '0',
      IS_RSTRAMB_INVERTED => '0',
      IS_RSTREGARSTREG_INVERTED => '0',
      IS_RSTREGB_INVERTED => '0',
      RAM_MODE => "SDP",
      RDADDR_COLLISION_HWCONFIG => "DELAYED_WRITE",
      READ_WIDTH_A => 36,
      READ_WIDTH_B => 0,
      RSTREG_PRIORITY_A => "REGCE",
      RSTREG_PRIORITY_B => "REGCE",
      SIM_COLLISION_CHECK => "NONE",
      SIM_DEVICE => "7SERIES",
      SRVAL_A => X"00000",
      SRVAL_B => X"00000",
      WRITE_MODE_A => "READ_FIRST",
      WRITE_MODE_B => "READ_FIRST",
      WRITE_WIDTH_A => 0,
      WRITE_WIDTH_B => 36
    )
        port map (
      ADDRARDADDR(13 downto 12) => B"00",
      ADDRARDADDR(11 downto 5) => addrb(6 downto 0),
      ADDRARDADDR(4 downto 0) => B"00000",
      ADDRBWRADDR(13 downto 12) => B"00",
      ADDRBWRADDR(11 downto 5) => addra(6 downto 0),
      ADDRBWRADDR(4 downto 0) => B"00000",
      CLKARDCLK => clka,
      CLKBWRCLK => clka,
      DIADI(15 downto 0) => dina(15 downto 0),
      DIBDI(15 downto 0) => dina(31 downto 16),
      DIPADIP(1 downto 0) => B"00",
      DIPBDIP(1 downto 0) => B"00",
      DOADO(15 downto 0) => doutb(15 downto 0),
      DOBDO(15 downto 0) => doutb(31 downto 16),
      DOPADOP(1) => \DEVICE_7SERIES.NO_BMM_INFO.SDP.WIDE_PRIM18.ram_n_32\,
      DOPADOP(0) => \DEVICE_7SERIES.NO_BMM_INFO.SDP.WIDE_PRIM18.ram_n_33\,
      DOPBDOP(1) => \DEVICE_7SERIES.NO_BMM_INFO.SDP.WIDE_PRIM18.ram_n_34\,
      DOPBDOP(0) => \DEVICE_7SERIES.NO_BMM_INFO.SDP.WIDE_PRIM18.ram_n_35\,
      ENARDEN => enb,
      ENBWREN => ena,
      REGCEAREGCE => '0',
      REGCEB => '0',
      RSTRAMARSTRAM => '0',
      RSTRAMB => '0',
      RSTREGARSTREG => '0',
      RSTREGB => '0',
      WEA(1 downto 0) => B"00",
      WEBWE(3 downto 0) => wea(3 downto 0)
    );
end STRUCTURE;
library IEEE;
use IEEE.STD_LOGIC_1164.ALL;
library UNISIM;
use UNISIM.VCOMPONENTS.ALL;
entity simple_dual_ram_blk_mem_gen_prim_width is
  port (
    doutb : out STD_LOGIC_VECTOR ( 31 downto 0 );
    clka : in STD_LOGIC;
    enb : in STD_LOGIC;
    ena : in STD_LOGIC;
    addrb : in STD_LOGIC_VECTOR ( 6 downto 0 );
    addra : in STD_LOGIC_VECTOR ( 6 downto 0 );
    dina : in STD_LOGIC_VECTOR ( 31 downto 0 );
    wea : in STD_LOGIC_VECTOR ( 3 downto 0 )
  );
  attribute ORIG_REF_NAME : string;
  attribute ORIG_REF_NAME of simple_dual_ram_blk_mem_gen_prim_width : entity is "blk_mem_gen_prim_width";
end simple_dual_ram_blk_mem_gen_prim_width;

architecture STRUCTURE of simple_dual_ram_blk_mem_gen_prim_width is
begin
\prim_noinit.ram\: entity work.simple_dual_ram_blk_mem_gen_prim_wrapper
     port map (
      addra(6 downto 0) => addra(6 downto 0),
      addrb(6 downto 0) => addrb(6 downto 0),
      clka => clka,
      dina(31 downto 0) => dina(31 downto 0),
      doutb(31 downto 0) => doutb(31 downto 0),
      ena => ena,
      enb => enb,
      wea(3 downto 0) => wea(3 downto 0)
    );
end STRUCTURE;
library IEEE;
use IEEE.STD_LOGIC_1164.ALL;
library UNISIM;
use UNISIM.VCOMPONENTS.ALL;
entity simple_dual_ram_blk_mem_gen_generic_cstr is
  port (
    doutb : out STD_LOGIC_VECTOR ( 31 downto 0 );
    clka : in STD_LOGIC;
    enb : in STD_LOGIC;
    ena : in STD_LOGIC;
    addrb : in STD_LOGIC_VECTOR ( 6 downto 0 );
    addra : in STD_LOGIC_VECTOR ( 6 downto 0 );
    dina : in STD_LOGIC_VECTOR ( 31 downto 0 );
    wea : in STD_LOGIC_VECTOR ( 3 downto 0 )
  );
  attribute ORIG_REF_NAME : string;
  attribute ORIG_REF_NAME of simple_dual_ram_blk_mem_gen_generic_cstr : entity is "blk_mem_gen_generic_cstr";
end simple_dual_ram_blk_mem_gen_generic_cstr;

architecture STRUCTURE of simple_dual_ram_blk_mem_gen_generic_cstr is
begin
\ramloop[0].ram.r\: entity work.simple_dual_ram_blk_mem_gen_prim_width
     port map (
      addra(6 downto 0) => addra(6 downto 0),
      addrb(6 downto 0) => addrb(6 downto 0),
      clka => clka,
      dina(31 downto 0) => dina(31 downto 0),
      doutb(31 downto 0) => doutb(31 downto 0),
      ena => ena,
      enb => enb,
      wea(3 downto 0) => wea(3 downto 0)
    );
end STRUCTURE;
library IEEE;
use IEEE.STD_LOGIC_1164.ALL;
library UNISIM;
use UNISIM.VCOMPONENTS.ALL;
entity simple_dual_ram_blk_mem_gen_top is
  port (
    doutb : out STD_LOGIC_VECTOR ( 31 downto 0 );
    clka : in STD_LOGIC;
    enb : in STD_LOGIC;
    ena : in STD_LOGIC;
    addrb : in STD_LOGIC_VECTOR ( 6 downto 0 );
    addra : in STD_LOGIC_VECTOR ( 6 downto 0 );
    dina : in STD_LOGIC_VECTOR ( 31 downto 0 );
    wea : in STD_LOGIC_VECTOR ( 3 downto 0 )
  );
  attribute ORIG_REF_NAME : string;
  attribute ORIG_REF_NAME of simple_dual_ram_blk_mem_gen_top : entity is "blk_mem_gen_top";
end simple_dual_ram_blk_mem_gen_top;

architecture STRUCTURE of simple_dual_ram_blk_mem_gen_top is
begin
\valid.cstr\: entity work.simple_dual_ram_blk_mem_gen_generic_cstr
     port map (
      addra(6 downto 0) => addra(6 downto 0),
      addrb(6 downto 0) => addrb(6 downto 0),
      clka => clka,
      dina(31 downto 0) => dina(31 downto 0),
      doutb(31 downto 0) => doutb(31 downto 0),
      ena => ena,
      enb => enb,
      wea(3 downto 0) => wea(3 downto 0)
    );
end STRUCTURE;
library IEEE;
use IEEE.STD_LOGIC_1164.ALL;
library UNISIM;
use UNISIM.VCOMPONENTS.ALL;
entity simple_dual_ram_blk_mem_gen_v8_4_4_synth is
  port (
    doutb : out STD_LOGIC_VECTOR ( 31 downto 0 );
    clka : in STD_LOGIC;
    enb : in STD_LOGIC;
    ena : in STD_LOGIC;
    addrb : in STD_LOGIC_VECTOR ( 6 downto 0 );
    addra : in STD_LOGIC_VECTOR ( 6 downto 0 );
    dina : in STD_LOGIC_VECTOR ( 31 downto 0 );
    wea : in STD_LOGIC_VECTOR ( 3 downto 0 )
  );
  attribute ORIG_REF_NAME : string;
  attribute ORIG_REF_NAME of simple_dual_ram_blk_mem_gen_v8_4_4_synth : entity is "blk_mem_gen_v8_4_4_synth";
end simple_dual_ram_blk_mem_gen_v8_4_4_synth;

architecture STRUCTURE of simple_dual_ram_blk_mem_gen_v8_4_4_synth is
begin
\gnbram.gnativebmg.native_blk_mem_gen\: entity work.simple_dual_ram_blk_mem_gen_top
     port map (
      addra(6 downto 0) => addra(6 downto 0),
      addrb(6 downto 0) => addrb(6 downto 0),
      clka => clka,
      dina(31 downto 0) => dina(31 downto 0),
      doutb(31 downto 0) => doutb(31 downto 0),
      ena => ena,
      enb => enb,
      wea(3 downto 0) => wea(3 downto 0)
    );
end STRUCTURE;
library IEEE;
use IEEE.STD_LOGIC_1164.ALL;
library UNISIM;
use UNISIM.VCOMPONENTS.ALL;
entity simple_dual_ram_blk_mem_gen_v8_4_4 is
  port (
    clka : in STD_LOGIC;
    rsta : in STD_LOGIC;
    ena : in STD_LOGIC;
    regcea : in STD_LOGIC;
    wea : in STD_LOGIC_VECTOR ( 3 downto 0 );
    addra : in STD_LOGIC_VECTOR ( 6 downto 0 );
    dina : in STD_LOGIC_VECTOR ( 31 downto 0 );
    douta : out STD_LOGIC_VECTOR ( 31 downto 0 );
    clkb : in STD_LOGIC;
    rstb : in STD_LOGIC;
    enb : in STD_LOGIC;
    regceb : in STD_LOGIC;
    web : in STD_LOGIC_VECTOR ( 3 downto 0 );
    addrb : in STD_LOGIC_VECTOR ( 6 downto 0 );
    dinb : in STD_LOGIC_VECTOR ( 31 downto 0 );
    doutb : out STD_LOGIC_VECTOR ( 31 downto 0 );
    injectsbiterr : in STD_LOGIC;
    injectdbiterr : in STD_LOGIC;
    eccpipece : in STD_LOGIC;
    sbiterr : out STD_LOGIC;
    dbiterr : out STD_LOGIC;
    rdaddrecc : out STD_LOGIC_VECTOR ( 6 downto 0 );
    sleep : in STD_LOGIC;
    deepsleep : in STD_LOGIC;
    shutdown : in STD_LOGIC;
    rsta_busy : out STD_LOGIC;
    rstb_busy : out STD_LOGIC;
    s_aclk : in STD_LOGIC;
    s_aresetn : in STD_LOGIC;
    s_axi_awid : in STD_LOGIC_VECTOR ( 3 downto 0 );
    s_axi_awaddr : in STD_LOGIC_VECTOR ( 31 downto 0 );
    s_axi_awlen : in STD_LOGIC_VECTOR ( 7 downto 0 );
    s_axi_awsize : in STD_LOGIC_VECTOR ( 2 downto 0 );
    s_axi_awburst : in STD_LOGIC_VECTOR ( 1 downto 0 );
    s_axi_awvalid : in STD_LOGIC;
    s_axi_awready : out STD_LOGIC;
    s_axi_wdata : in STD_LOGIC_VECTOR ( 31 downto 0 );
    s_axi_wstrb : in STD_LOGIC_VECTOR ( 3 downto 0 );
    s_axi_wlast : in STD_LOGIC;
    s_axi_wvalid : in STD_LOGIC;
    s_axi_wready : out STD_LOGIC;
    s_axi_bid : out STD_LOGIC_VECTOR ( 3 downto 0 );
    s_axi_bresp : out STD_LOGIC_VECTOR ( 1 downto 0 );
    s_axi_bvalid : out STD_LOGIC;
    s_axi_bready : in STD_LOGIC;
    s_axi_arid : in STD_LOGIC_VECTOR ( 3 downto 0 );
    s_axi_araddr : in STD_LOGIC_VECTOR ( 31 downto 0 );
    s_axi_arlen : in STD_LOGIC_VECTOR ( 7 downto 0 );
    s_axi_arsize : in STD_LOGIC_VECTOR ( 2 downto 0 );
    s_axi_arburst : in STD_LOGIC_VECTOR ( 1 downto 0 );
    s_axi_arvalid : in STD_LOGIC;
    s_axi_arready : out STD_LOGIC;
    s_axi_rid : out STD_LOGIC_VECTOR ( 3 downto 0 );
    s_axi_rdata : out STD_LOGIC_VECTOR ( 31 downto 0 );
    s_axi_rresp : out STD_LOGIC_VECTOR ( 1 downto 0 );
    s_axi_rlast : out STD_LOGIC;
    s_axi_rvalid : out STD_LOGIC;
    s_axi_rready : in STD_LOGIC;
    s_axi_injectsbiterr : in STD_LOGIC;
    s_axi_injectdbiterr : in STD_LOGIC;
    s_axi_sbiterr : out STD_LOGIC;
    s_axi_dbiterr : out STD_LOGIC;
    s_axi_rdaddrecc : out STD_LOGIC_VECTOR ( 6 downto 0 )
  );
  attribute C_ADDRA_WIDTH : integer;
  attribute C_ADDRA_WIDTH of simple_dual_ram_blk_mem_gen_v8_4_4 : entity is 7;
  attribute C_ADDRB_WIDTH : integer;
  attribute C_ADDRB_WIDTH of simple_dual_ram_blk_mem_gen_v8_4_4 : entity is 7;
  attribute C_ALGORITHM : integer;
  attribute C_ALGORITHM of simple_dual_ram_blk_mem_gen_v8_4_4 : entity is 1;
  attribute C_AXI_ID_WIDTH : integer;
  attribute C_AXI_ID_WIDTH of simple_dual_ram_blk_mem_gen_v8_4_4 : entity is 4;
  attribute C_AXI_SLAVE_TYPE : integer;
  attribute C_AXI_SLAVE_TYPE of simple_dual_ram_blk_mem_gen_v8_4_4 : entity is 0;
  attribute C_AXI_TYPE : integer;
  attribute C_AXI_TYPE of simple_dual_ram_blk_mem_gen_v8_4_4 : entity is 1;
  attribute C_BYTE_SIZE : integer;
  attribute C_BYTE_SIZE of simple_dual_ram_blk_mem_gen_v8_4_4 : entity is 8;
  attribute C_COMMON_CLK : integer;
  attribute C_COMMON_CLK of simple_dual_ram_blk_mem_gen_v8_4_4 : entity is 1;
  attribute C_COUNT_18K_BRAM : string;
  attribute C_COUNT_18K_BRAM of simple_dual_ram_blk_mem_gen_v8_4_4 : entity is "1";
  attribute C_COUNT_36K_BRAM : string;
  attribute C_COUNT_36K_BRAM of simple_dual_ram_blk_mem_gen_v8_4_4 : entity is "0";
  attribute C_CTRL_ECC_ALGO : string;
  attribute C_CTRL_ECC_ALGO of simple_dual_ram_blk_mem_gen_v8_4_4 : entity is "NONE";
  attribute C_DEFAULT_DATA : string;
  attribute C_DEFAULT_DATA of simple_dual_ram_blk_mem_gen_v8_4_4 : entity is "0";
  attribute C_DISABLE_WARN_BHV_COLL : integer;
  attribute C_DISABLE_WARN_BHV_COLL of simple_dual_ram_blk_mem_gen_v8_4_4 : entity is 1;
  attribute C_DISABLE_WARN_BHV_RANGE : integer;
  attribute C_DISABLE_WARN_BHV_RANGE of simple_dual_ram_blk_mem_gen_v8_4_4 : entity is 1;
  attribute C_ELABORATION_DIR : string;
  attribute C_ELABORATION_DIR of simple_dual_ram_blk_mem_gen_v8_4_4 : entity is "./";
  attribute C_ENABLE_32BIT_ADDRESS : integer;
  attribute C_ENABLE_32BIT_ADDRESS of simple_dual_ram_blk_mem_gen_v8_4_4 : entity is 0;
  attribute C_EN_DEEPSLEEP_PIN : integer;
  attribute C_EN_DEEPSLEEP_PIN of simple_dual_ram_blk_mem_gen_v8_4_4 : entity is 0;
  attribute C_EN_ECC_PIPE : integer;
  attribute C_EN_ECC_PIPE of simple_dual_ram_blk_mem_gen_v8_4_4 : entity is 0;
  attribute C_EN_RDADDRA_CHG : integer;
  attribute C_EN_RDADDRA_CHG of simple_dual_ram_blk_mem_gen_v8_4_4 : entity is 0;
  attribute C_EN_RDADDRB_CHG : integer;
  attribute C_EN_RDADDRB_CHG of simple_dual_ram_blk_mem_gen_v8_4_4 : entity is 0;
  attribute C_EN_SAFETY_CKT : integer;
  attribute C_EN_SAFETY_CKT of simple_dual_ram_blk_mem_gen_v8_4_4 : entity is 0;
  attribute C_EN_SHUTDOWN_PIN : integer;
  attribute C_EN_SHUTDOWN_PIN of simple_dual_ram_blk_mem_gen_v8_4_4 : entity is 0;
  attribute C_EN_SLEEP_PIN : integer;
  attribute C_EN_SLEEP_PIN of simple_dual_ram_blk_mem_gen_v8_4_4 : entity is 0;
  attribute C_EST_POWER_SUMMARY : string;
  attribute C_EST_POWER_SUMMARY of simple_dual_ram_blk_mem_gen_v8_4_4 : entity is "Estimated Power for IP     :     3.68295 mW";
  attribute C_FAMILY : string;
  attribute C_FAMILY of simple_dual_ram_blk_mem_gen_v8_4_4 : entity is "artix7";
  attribute C_HAS_AXI_ID : integer;
  attribute C_HAS_AXI_ID of simple_dual_ram_blk_mem_gen_v8_4_4 : entity is 0;
  attribute C_HAS_ENA : integer;
  attribute C_HAS_ENA of simple_dual_ram_blk_mem_gen_v8_4_4 : entity is 1;
  attribute C_HAS_ENB : integer;
  attribute C_HAS_ENB of simple_dual_ram_blk_mem_gen_v8_4_4 : entity is 1;
  attribute C_HAS_INJECTERR : integer;
  attribute C_HAS_INJECTERR of simple_dual_ram_blk_mem_gen_v8_4_4 : entity is 0;
  attribute C_HAS_MEM_OUTPUT_REGS_A : integer;
  attribute C_HAS_MEM_OUTPUT_REGS_A of simple_dual_ram_blk_mem_gen_v8_4_4 : entity is 0;
  attribute C_HAS_MEM_OUTPUT_REGS_B : integer;
  attribute C_HAS_MEM_OUTPUT_REGS_B of simple_dual_ram_blk_mem_gen_v8_4_4 : entity is 0;
  attribute C_HAS_MUX_OUTPUT_REGS_A : integer;
  attribute C_HAS_MUX_OUTPUT_REGS_A of simple_dual_ram_blk_mem_gen_v8_4_4 : entity is 0;
  attribute C_HAS_MUX_OUTPUT_REGS_B : integer;
  attribute C_HAS_MUX_OUTPUT_REGS_B of simple_dual_ram_blk_mem_gen_v8_4_4 : entity is 0;
  attribute C_HAS_REGCEA : integer;
  attribute C_HAS_REGCEA of simple_dual_ram_blk_mem_gen_v8_4_4 : entity is 0;
  attribute C_HAS_REGCEB : integer;
  attribute C_HAS_REGCEB of simple_dual_ram_blk_mem_gen_v8_4_4 : entity is 0;
  attribute C_HAS_RSTA : integer;
  attribute C_HAS_RSTA of simple_dual_ram_blk_mem_gen_v8_4_4 : entity is 0;
  attribute C_HAS_RSTB : integer;
  attribute C_HAS_RSTB of simple_dual_ram_blk_mem_gen_v8_4_4 : entity is 0;
  attribute C_HAS_SOFTECC_INPUT_REGS_A : integer;
  attribute C_HAS_SOFTECC_INPUT_REGS_A of simple_dual_ram_blk_mem_gen_v8_4_4 : entity is 0;
  attribute C_HAS_SOFTECC_OUTPUT_REGS_B : integer;
  attribute C_HAS_SOFTECC_OUTPUT_REGS_B of simple_dual_ram_blk_mem_gen_v8_4_4 : entity is 0;
  attribute C_INITA_VAL : string;
  attribute C_INITA_VAL of simple_dual_ram_blk_mem_gen_v8_4_4 : entity is "0";
  attribute C_INITB_VAL : string;
  attribute C_INITB_VAL of simple_dual_ram_blk_mem_gen_v8_4_4 : entity is "0";
  attribute C_INIT_FILE : string;
  attribute C_INIT_FILE of simple_dual_ram_blk_mem_gen_v8_4_4 : entity is "simple_dual_ram.mem";
  attribute C_INIT_FILE_NAME : string;
  attribute C_INIT_FILE_NAME of simple_dual_ram_blk_mem_gen_v8_4_4 : entity is "no_coe_file_loaded";
  attribute C_INTERFACE_TYPE : integer;
  attribute C_INTERFACE_TYPE of simple_dual_ram_blk_mem_gen_v8_4_4 : entity is 0;
  attribute C_LOAD_INIT_FILE : integer;
  attribute C_LOAD_INIT_FILE of simple_dual_ram_blk_mem_gen_v8_4_4 : entity is 0;
  attribute C_MEM_TYPE : integer;
  attribute C_MEM_TYPE of simple_dual_ram_blk_mem_gen_v8_4_4 : entity is 1;
  attribute C_MUX_PIPELINE_STAGES : integer;
  attribute C_MUX_PIPELINE_STAGES of simple_dual_ram_blk_mem_gen_v8_4_4 : entity is 0;
  attribute C_PRIM_TYPE : integer;
  attribute C_PRIM_TYPE of simple_dual_ram_blk_mem_gen_v8_4_4 : entity is 1;
  attribute C_READ_DEPTH_A : integer;
  attribute C_READ_DEPTH_A of simple_dual_ram_blk_mem_gen_v8_4_4 : entity is 128;
  attribute C_READ_DEPTH_B : integer;
  attribute C_READ_DEPTH_B of simple_dual_ram_blk_mem_gen_v8_4_4 : entity is 128;
  attribute C_READ_LATENCY_A : integer;
  attribute C_READ_LATENCY_A of simple_dual_ram_blk_mem_gen_v8_4_4 : entity is 1;
  attribute C_READ_LATENCY_B : integer;
  attribute C_READ_LATENCY_B of simple_dual_ram_blk_mem_gen_v8_4_4 : entity is 1;
  attribute C_READ_WIDTH_A : integer;
  attribute C_READ_WIDTH_A of simple_dual_ram_blk_mem_gen_v8_4_4 : entity is 32;
  attribute C_READ_WIDTH_B : integer;
  attribute C_READ_WIDTH_B of simple_dual_ram_blk_mem_gen_v8_4_4 : entity is 32;
  attribute C_RSTRAM_A : integer;
  attribute C_RSTRAM_A of simple_dual_ram_blk_mem_gen_v8_4_4 : entity is 0;
  attribute C_RSTRAM_B : integer;
  attribute C_RSTRAM_B of simple_dual_ram_blk_mem_gen_v8_4_4 : entity is 0;
  attribute C_RST_PRIORITY_A : string;
  attribute C_RST_PRIORITY_A of simple_dual_ram_blk_mem_gen_v8_4_4 : entity is "CE";
  attribute C_RST_PRIORITY_B : string;
  attribute C_RST_PRIORITY_B of simple_dual_ram_blk_mem_gen_v8_4_4 : entity is "CE";
  attribute C_SIM_COLLISION_CHECK : string;
  attribute C_SIM_COLLISION_CHECK of simple_dual_ram_blk_mem_gen_v8_4_4 : entity is "NONE";
  attribute C_USE_BRAM_BLOCK : integer;
  attribute C_USE_BRAM_BLOCK of simple_dual_ram_blk_mem_gen_v8_4_4 : entity is 0;
  attribute C_USE_BYTE_WEA : integer;
  attribute C_USE_BYTE_WEA of simple_dual_ram_blk_mem_gen_v8_4_4 : entity is 1;
  attribute C_USE_BYTE_WEB : integer;
  attribute C_USE_BYTE_WEB of simple_dual_ram_blk_mem_gen_v8_4_4 : entity is 1;
  attribute C_USE_DEFAULT_DATA : integer;
  attribute C_USE_DEFAULT_DATA of simple_dual_ram_blk_mem_gen_v8_4_4 : entity is 0;
  attribute C_USE_ECC : integer;
  attribute C_USE_ECC of simple_dual_ram_blk_mem_gen_v8_4_4 : entity is 0;
  attribute C_USE_SOFTECC : integer;
  attribute C_USE_SOFTECC of simple_dual_ram_blk_mem_gen_v8_4_4 : entity is 0;
  attribute C_USE_URAM : integer;
  attribute C_USE_URAM of simple_dual_ram_blk_mem_gen_v8_4_4 : entity is 0;
  attribute C_WEA_WIDTH : integer;
  attribute C_WEA_WIDTH of simple_dual_ram_blk_mem_gen_v8_4_4 : entity is 4;
  attribute C_WEB_WIDTH : integer;
  attribute C_WEB_WIDTH of simple_dual_ram_blk_mem_gen_v8_4_4 : entity is 4;
  attribute C_WRITE_DEPTH_A : integer;
  attribute C_WRITE_DEPTH_A of simple_dual_ram_blk_mem_gen_v8_4_4 : entity is 128;
  attribute C_WRITE_DEPTH_B : integer;
  attribute C_WRITE_DEPTH_B of simple_dual_ram_blk_mem_gen_v8_4_4 : entity is 128;
  attribute C_WRITE_MODE_A : string;
  attribute C_WRITE_MODE_A of simple_dual_ram_blk_mem_gen_v8_4_4 : entity is "NO_CHANGE";
  attribute C_WRITE_MODE_B : string;
  attribute C_WRITE_MODE_B of simple_dual_ram_blk_mem_gen_v8_4_4 : entity is "READ_FIRST";
  attribute C_WRITE_WIDTH_A : integer;
  attribute C_WRITE_WIDTH_A of simple_dual_ram_blk_mem_gen_v8_4_4 : entity is 32;
  attribute C_WRITE_WIDTH_B : integer;
  attribute C_WRITE_WIDTH_B of simple_dual_ram_blk_mem_gen_v8_4_4 : entity is 32;
  attribute C_XDEVICEFAMILY : string;
  attribute C_XDEVICEFAMILY of simple_dual_ram_blk_mem_gen_v8_4_4 : entity is "artix7";
  attribute ORIG_REF_NAME : string;
  attribute ORIG_REF_NAME of simple_dual_ram_blk_mem_gen_v8_4_4 : entity is "blk_mem_gen_v8_4_4";
  attribute downgradeipidentifiedwarnings : string;
  attribute downgradeipidentifiedwarnings of simple_dual_ram_blk_mem_gen_v8_4_4 : entity is "yes";
end simple_dual_ram_blk_mem_gen_v8_4_4;

architecture STRUCTURE of simple_dual_ram_blk_mem_gen_v8_4_4 is
  signal \<const0>\ : STD_LOGIC;
begin
  dbiterr <= \<const0>\;
  douta(31) <= \<const0>\;
  douta(30) <= \<const0>\;
  douta(29) <= \<const0>\;
  douta(28) <= \<const0>\;
  douta(27) <= \<const0>\;
  douta(26) <= \<const0>\;
  douta(25) <= \<const0>\;
  douta(24) <= \<const0>\;
  douta(23) <= \<const0>\;
  douta(22) <= \<const0>\;
  douta(21) <= \<const0>\;
  douta(20) <= \<const0>\;
  douta(19) <= \<const0>\;
  douta(18) <= \<const0>\;
  douta(17) <= \<const0>\;
  douta(16) <= \<const0>\;
  douta(15) <= \<const0>\;
  douta(14) <= \<const0>\;
  douta(13) <= \<const0>\;
  douta(12) <= \<const0>\;
  douta(11) <= \<const0>\;
  douta(10) <= \<const0>\;
  douta(9) <= \<const0>\;
  douta(8) <= \<const0>\;
  douta(7) <= \<const0>\;
  douta(6) <= \<const0>\;
  douta(5) <= \<const0>\;
  douta(4) <= \<const0>\;
  douta(3) <= \<const0>\;
  douta(2) <= \<const0>\;
  douta(1) <= \<const0>\;
  douta(0) <= \<const0>\;
  rdaddrecc(6) <= \<const0>\;
  rdaddrecc(5) <= \<const0>\;
  rdaddrecc(4) <= \<const0>\;
  rdaddrecc(3) <= \<const0>\;
  rdaddrecc(2) <= \<const0>\;
  rdaddrecc(1) <= \<const0>\;
  rdaddrecc(0) <= \<const0>\;
  rsta_busy <= \<const0>\;
  rstb_busy <= \<const0>\;
  s_axi_arready <= \<const0>\;
  s_axi_awready <= \<const0>\;
  s_axi_bid(3) <= \<const0>\;
  s_axi_bid(2) <= \<const0>\;
  s_axi_bid(1) <= \<const0>\;
  s_axi_bid(0) <= \<const0>\;
  s_axi_bresp(1) <= \<const0>\;
  s_axi_bresp(0) <= \<const0>\;
  s_axi_bvalid <= \<const0>\;
  s_axi_dbiterr <= \<const0>\;
  s_axi_rdaddrecc(6) <= \<const0>\;
  s_axi_rdaddrecc(5) <= \<const0>\;
  s_axi_rdaddrecc(4) <= \<const0>\;
  s_axi_rdaddrecc(3) <= \<const0>\;
  s_axi_rdaddrecc(2) <= \<const0>\;
  s_axi_rdaddrecc(1) <= \<const0>\;
  s_axi_rdaddrecc(0) <= \<const0>\;
  s_axi_rdata(31) <= \<const0>\;
  s_axi_rdata(30) <= \<const0>\;
  s_axi_rdata(29) <= \<const0>\;
  s_axi_rdata(28) <= \<const0>\;
  s_axi_rdata(27) <= \<const0>\;
  s_axi_rdata(26) <= \<const0>\;
  s_axi_rdata(25) <= \<const0>\;
  s_axi_rdata(24) <= \<const0>\;
  s_axi_rdata(23) <= \<const0>\;
  s_axi_rdata(22) <= \<const0>\;
  s_axi_rdata(21) <= \<const0>\;
  s_axi_rdata(20) <= \<const0>\;
  s_axi_rdata(19) <= \<const0>\;
  s_axi_rdata(18) <= \<const0>\;
  s_axi_rdata(17) <= \<const0>\;
  s_axi_rdata(16) <= \<const0>\;
  s_axi_rdata(15) <= \<const0>\;
  s_axi_rdata(14) <= \<const0>\;
  s_axi_rdata(13) <= \<const0>\;
  s_axi_rdata(12) <= \<const0>\;
  s_axi_rdata(11) <= \<const0>\;
  s_axi_rdata(10) <= \<const0>\;
  s_axi_rdata(9) <= \<const0>\;
  s_axi_rdata(8) <= \<const0>\;
  s_axi_rdata(7) <= \<const0>\;
  s_axi_rdata(6) <= \<const0>\;
  s_axi_rdata(5) <= \<const0>\;
  s_axi_rdata(4) <= \<const0>\;
  s_axi_rdata(3) <= \<const0>\;
  s_axi_rdata(2) <= \<const0>\;
  s_axi_rdata(1) <= \<const0>\;
  s_axi_rdata(0) <= \<const0>\;
  s_axi_rid(3) <= \<const0>\;
  s_axi_rid(2) <= \<const0>\;
  s_axi_rid(1) <= \<const0>\;
  s_axi_rid(0) <= \<const0>\;
  s_axi_rlast <= \<const0>\;
  s_axi_rresp(1) <= \<const0>\;
  s_axi_rresp(0) <= \<const0>\;
  s_axi_rvalid <= \<const0>\;
  s_axi_sbiterr <= \<const0>\;
  s_axi_wready <= \<const0>\;
  sbiterr <= \<const0>\;
GND: unisim.vcomponents.GND
     port map (
      G => \<const0>\
    );
inst_blk_mem_gen: entity work.simple_dual_ram_blk_mem_gen_v8_4_4_synth
     port map (
      addra(6 downto 0) => addra(6 downto 0),
      addrb(6 downto 0) => addrb(6 downto 0),
      clka => clka,
      dina(31 downto 0) => dina(31 downto 0),
      doutb(31 downto 0) => doutb(31 downto 0),
      ena => ena,
      enb => enb,
      wea(3 downto 0) => wea(3 downto 0)
    );
end STRUCTURE;
library IEEE;
use IEEE.STD_LOGIC_1164.ALL;
library UNISIM;
use UNISIM.VCOMPONENTS.ALL;
entity simple_dual_ram is
  port (
    clka : in STD_LOGIC;
    ena : in STD_LOGIC;
    wea : in STD_LOGIC_VECTOR ( 3 downto 0 );
    addra : in STD_LOGIC_VECTOR ( 6 downto 0 );
    dina : in STD_LOGIC_VECTOR ( 31 downto 0 );
    clkb : in STD_LOGIC;
    enb : in STD_LOGIC;
    addrb : in STD_LOGIC_VECTOR ( 6 downto 0 );
    doutb : out STD_LOGIC_VECTOR ( 31 downto 0 )
  );
  attribute NotValidForBitStream : boolean;
  attribute NotValidForBitStream of simple_dual_ram : entity is true;
  attribute CHECK_LICENSE_TYPE : string;
  attribute CHECK_LICENSE_TYPE of simple_dual_ram : entity is "simple_dual_ram,blk_mem_gen_v8_4_4,{}";
  attribute downgradeipidentifiedwarnings : string;
  attribute downgradeipidentifiedwarnings of simple_dual_ram : entity is "yes";
  attribute x_core_info : string;
  attribute x_core_info of simple_dual_ram : entity is "blk_mem_gen_v8_4_4,Vivado 2019.2";
end simple_dual_ram;

architecture STRUCTURE of simple_dual_ram is
  signal NLW_U0_dbiterr_UNCONNECTED : STD_LOGIC;
  signal NLW_U0_rsta_busy_UNCONNECTED : STD_LOGIC;
  signal NLW_U0_rstb_busy_UNCONNECTED : STD_LOGIC;
  signal NLW_U0_s_axi_arready_UNCONNECTED : STD_LOGIC;
  signal NLW_U0_s_axi_awready_UNCONNECTED : STD_LOGIC;
  signal NLW_U0_s_axi_bvalid_UNCONNECTED : STD_LOGIC;
  signal NLW_U0_s_axi_dbiterr_UNCONNECTED : STD_LOGIC;
  signal NLW_U0_s_axi_rlast_UNCONNECTED : STD_LOGIC;
  signal NLW_U0_s_axi_rvalid_UNCONNECTED : STD_LOGIC;
  signal NLW_U0_s_axi_sbiterr_UNCONNECTED : STD_LOGIC;
  signal NLW_U0_s_axi_wready_UNCONNECTED : STD_LOGIC;
  signal NLW_U0_sbiterr_UNCONNECTED : STD_LOGIC;
  signal NLW_U0_douta_UNCONNECTED : STD_LOGIC_VECTOR ( 31 downto 0 );
  signal NLW_U0_rdaddrecc_UNCONNECTED : STD_LOGIC_VECTOR ( 6 downto 0 );
  signal NLW_U0_s_axi_bid_UNCONNECTED : STD_LOGIC_VECTOR ( 3 downto 0 );
  signal NLW_U0_s_axi_bresp_UNCONNECTED : STD_LOGIC_VECTOR ( 1 downto 0 );
  signal NLW_U0_s_axi_rdaddrecc_UNCONNECTED : STD_LOGIC_VECTOR ( 6 downto 0 );
  signal NLW_U0_s_axi_rdata_UNCONNECTED : STD_LOGIC_VECTOR ( 31 downto 0 );
  signal NLW_U0_s_axi_rid_UNCONNECTED : STD_LOGIC_VECTOR ( 3 downto 0 );
  signal NLW_U0_s_axi_rresp_UNCONNECTED : STD_LOGIC_VECTOR ( 1 downto 0 );
  attribute C_ADDRA_WIDTH : integer;
  attribute C_ADDRA_WIDTH of U0 : label is 7;
  attribute C_ADDRB_WIDTH : integer;
  attribute C_ADDRB_WIDTH of U0 : label is 7;
  attribute C_ALGORITHM : integer;
  attribute C_ALGORITHM of U0 : label is 1;
  attribute C_AXI_ID_WIDTH : integer;
  attribute C_AXI_ID_WIDTH of U0 : label is 4;
  attribute C_AXI_SLAVE_TYPE : integer;
  attribute C_AXI_SLAVE_TYPE of U0 : label is 0;
  attribute C_AXI_TYPE : integer;
  attribute C_AXI_TYPE of U0 : label is 1;
  attribute C_BYTE_SIZE : integer;
  attribute C_BYTE_SIZE of U0 : label is 8;
  attribute C_COMMON_CLK : integer;
  attribute C_COMMON_CLK of U0 : label is 1;
  attribute C_COUNT_18K_BRAM : string;
  attribute C_COUNT_18K_BRAM of U0 : label is "1";
  attribute C_COUNT_36K_BRAM : string;
  attribute C_COUNT_36K_BRAM of U0 : label is "0";
  attribute C_CTRL_ECC_ALGO : string;
  attribute C_CTRL_ECC_ALGO of U0 : label is "NONE";
  attribute C_DEFAULT_DATA : string;
  attribute C_DEFAULT_DATA of U0 : label is "0";
  attribute C_DISABLE_WARN_BHV_COLL : integer;
  attribute C_DISABLE_WARN_BHV_COLL of U0 : label is 1;
  attribute C_DISABLE_WARN_BHV_RANGE : integer;
  attribute C_DISABLE_WARN_BHV_RANGE of U0 : label is 1;
  attribute C_ELABORATION_DIR : string;
  attribute C_ELABORATION_DIR of U0 : label is "./";
  attribute C_ENABLE_32BIT_ADDRESS : integer;
  attribute C_ENABLE_32BIT_ADDRESS of U0 : label is 0;
  attribute C_EN_DEEPSLEEP_PIN : integer;
  attribute C_EN_DEEPSLEEP_PIN of U0 : label is 0;
  attribute C_EN_ECC_PIPE : integer;
  attribute C_EN_ECC_PIPE of U0 : label is 0;
  attribute C_EN_RDADDRA_CHG : integer;
  attribute C_EN_RDADDRA_CHG of U0 : label is 0;
  attribute C_EN_RDADDRB_CHG : integer;
  attribute C_EN_RDADDRB_CHG of U0 : label is 0;
  attribute C_EN_SAFETY_CKT : integer;
  attribute C_EN_SAFETY_CKT of U0 : label is 0;
  attribute C_EN_SHUTDOWN_PIN : integer;
  attribute C_EN_SHUTDOWN_PIN of U0 : label is 0;
  attribute C_EN_SLEEP_PIN : integer;
  attribute C_EN_SLEEP_PIN of U0 : label is 0;
  attribute C_EST_POWER_SUMMARY : string;
  attribute C_EST_POWER_SUMMARY of U0 : label is "Estimated Power for IP     :     3.68295 mW";
  attribute C_FAMILY : string;
  attribute C_FAMILY of U0 : label is "artix7";
  attribute C_HAS_AXI_ID : integer;
  attribute C_HAS_AXI_ID of U0 : label is 0;
  attribute C_HAS_ENA : integer;
  attribute C_HAS_ENA of U0 : label is 1;
  attribute C_HAS_ENB : integer;
  attribute C_HAS_ENB of U0 : label is 1;
  attribute C_HAS_INJECTERR : integer;
  attribute C_HAS_INJECTERR of U0 : label is 0;
  attribute C_HAS_MEM_OUTPUT_REGS_A : integer;
  attribute C_HAS_MEM_OUTPUT_REGS_A of U0 : label is 0;
  attribute C_HAS_MEM_OUTPUT_REGS_B : integer;
  attribute C_HAS_MEM_OUTPUT_REGS_B of U0 : label is 0;
  attribute C_HAS_MUX_OUTPUT_REGS_A : integer;
  attribute C_HAS_MUX_OUTPUT_REGS_A of U0 : label is 0;
  attribute C_HAS_MUX_OUTPUT_REGS_B : integer;
  attribute C_HAS_MUX_OUTPUT_REGS_B of U0 : label is 0;
  attribute C_HAS_REGCEA : integer;
  attribute C_HAS_REGCEA of U0 : label is 0;
  attribute C_HAS_REGCEB : integer;
  attribute C_HAS_REGCEB of U0 : label is 0;
  attribute C_HAS_RSTA : integer;
  attribute C_HAS_RSTA of U0 : label is 0;
  attribute C_HAS_RSTB : integer;
  attribute C_HAS_RSTB of U0 : label is 0;
  attribute C_HAS_SOFTECC_INPUT_REGS_A : integer;
  attribute C_HAS_SOFTECC_INPUT_REGS_A of U0 : label is 0;
  attribute C_HAS_SOFTECC_OUTPUT_REGS_B : integer;
  attribute C_HAS_SOFTECC_OUTPUT_REGS_B of U0 : label is 0;
  attribute C_INITA_VAL : string;
  attribute C_INITA_VAL of U0 : label is "0";
  attribute C_INITB_VAL : string;
  attribute C_INITB_VAL of U0 : label is "0";
  attribute C_INIT_FILE : string;
  attribute C_INIT_FILE of U0 : label is "simple_dual_ram.mem";
  attribute C_INIT_FILE_NAME : string;
  attribute C_INIT_FILE_NAME of U0 : label is "no_coe_file_loaded";
  attribute C_INTERFACE_TYPE : integer;
  attribute C_INTERFACE_TYPE of U0 : label is 0;
  attribute C_LOAD_INIT_FILE : integer;
  attribute C_LOAD_INIT_FILE of U0 : label is 0;
  attribute C_MEM_TYPE : integer;
  attribute C_MEM_TYPE of U0 : label is 1;
  attribute C_MUX_PIPELINE_STAGES : integer;
  attribute C_MUX_PIPELINE_STAGES of U0 : label is 0;
  attribute C_PRIM_TYPE : integer;
  attribute C_PRIM_TYPE of U0 : label is 1;
  attribute C_READ_DEPTH_A : integer;
  attribute C_READ_DEPTH_A of U0 : label is 128;
  attribute C_READ_DEPTH_B : integer;
  attribute C_READ_DEPTH_B of U0 : label is 128;
  attribute C_READ_LATENCY_A : integer;
  attribute C_READ_LATENCY_A of U0 : label is 1;
  attribute C_READ_LATENCY_B : integer;
  attribute C_READ_LATENCY_B of U0 : label is 1;
  attribute C_READ_WIDTH_A : integer;
  attribute C_READ_WIDTH_A of U0 : label is 32;
  attribute C_READ_WIDTH_B : integer;
  attribute C_READ_WIDTH_B of U0 : label is 32;
  attribute C_RSTRAM_A : integer;
  attribute C_RSTRAM_A of U0 : label is 0;
  attribute C_RSTRAM_B : integer;
  attribute C_RSTRAM_B of U0 : label is 0;
  attribute C_RST_PRIORITY_A : string;
  attribute C_RST_PRIORITY_A of U0 : label is "CE";
  attribute C_RST_PRIORITY_B : string;
  attribute C_RST_PRIORITY_B of U0 : label is "CE";
  attribute C_SIM_COLLISION_CHECK : string;
  attribute C_SIM_COLLISION_CHECK of U0 : label is "NONE";
  attribute C_USE_BRAM_BLOCK : integer;
  attribute C_USE_BRAM_BLOCK of U0 : label is 0;
  attribute C_USE_BYTE_WEA : integer;
  attribute C_USE_BYTE_WEA of U0 : label is 1;
  attribute C_USE_BYTE_WEB : integer;
  attribute C_USE_BYTE_WEB of U0 : label is 1;
  attribute C_USE_DEFAULT_DATA : integer;
  attribute C_USE_DEFAULT_DATA of U0 : label is 0;
  attribute C_USE_ECC : integer;
  attribute C_USE_ECC of U0 : label is 0;
  attribute C_USE_SOFTECC : integer;
  attribute C_USE_SOFTECC of U0 : label is 0;
  attribute C_USE_URAM : integer;
  attribute C_USE_URAM of U0 : label is 0;
  attribute C_WEA_WIDTH : integer;
  attribute C_WEA_WIDTH of U0 : label is 4;
  attribute C_WEB_WIDTH : integer;
  attribute C_WEB_WIDTH of U0 : label is 4;
  attribute C_WRITE_DEPTH_A : integer;
  attribute C_WRITE_DEPTH_A of U0 : label is 128;
  attribute C_WRITE_DEPTH_B : integer;
  attribute C_WRITE_DEPTH_B of U0 : label is 128;
  attribute C_WRITE_MODE_A : string;
  attribute C_WRITE_MODE_A of U0 : label is "NO_CHANGE";
  attribute C_WRITE_MODE_B : string;
  attribute C_WRITE_MODE_B of U0 : label is "READ_FIRST";
  attribute C_WRITE_WIDTH_A : integer;
  attribute C_WRITE_WIDTH_A of U0 : label is 32;
  attribute C_WRITE_WIDTH_B : integer;
  attribute C_WRITE_WIDTH_B of U0 : label is 32;
  attribute C_XDEVICEFAMILY : string;
  attribute C_XDEVICEFAMILY of U0 : label is "artix7";
  attribute downgradeipidentifiedwarnings of U0 : label is "yes";
  attribute x_interface_info : string;
  attribute x_interface_info of clka : signal is "xilinx.com:interface:bram:1.0 BRAM_PORTA CLK";
  attribute x_interface_parameter : string;
  attribute x_interface_parameter of clka : signal is "XIL_INTERFACENAME BRAM_PORTA, MEM_SIZE 8192, MEM_WIDTH 32, MEM_ECC NONE, MASTER_TYPE OTHER, READ_LATENCY 1";
  attribute x_interface_info of clkb : signal is "xilinx.com:interface:bram:1.0 BRAM_PORTB CLK";
  attribute x_interface_parameter of clkb : signal is "XIL_INTERFACENAME BRAM_PORTB, MEM_SIZE 8192, MEM_WIDTH 32, MEM_ECC NONE, MASTER_TYPE OTHER, READ_LATENCY 1";
  attribute x_interface_info of ena : signal is "xilinx.com:interface:bram:1.0 BRAM_PORTA EN";
  attribute x_interface_info of enb : signal is "xilinx.com:interface:bram:1.0 BRAM_PORTB EN";
  attribute x_interface_info of addra : signal is "xilinx.com:interface:bram:1.0 BRAM_PORTA ADDR";
  attribute x_interface_info of addrb : signal is "xilinx.com:interface:bram:1.0 BRAM_PORTB ADDR";
  attribute x_interface_info of dina : signal is "xilinx.com:interface:bram:1.0 BRAM_PORTA DIN";
  attribute x_interface_info of doutb : signal is "xilinx.com:interface:bram:1.0 BRAM_PORTB DOUT";
  attribute x_interface_info of wea : signal is "xilinx.com:interface:bram:1.0 BRAM_PORTA WE";
begin
U0: entity work.simple_dual_ram_blk_mem_gen_v8_4_4
     port map (
      addra(6 downto 0) => addra(6 downto 0),
      addrb(6 downto 0) => addrb(6 downto 0),
      clka => clka,
      clkb => clkb,
      dbiterr => NLW_U0_dbiterr_UNCONNECTED,
      deepsleep => '0',
      dina(31 downto 0) => dina(31 downto 0),
      dinb(31 downto 0) => B"00000000000000000000000000000000",
      douta(31 downto 0) => NLW_U0_douta_UNCONNECTED(31 downto 0),
      doutb(31 downto 0) => doutb(31 downto 0),
      eccpipece => '0',
      ena => ena,
      enb => enb,
      injectdbiterr => '0',
      injectsbiterr => '0',
      rdaddrecc(6 downto 0) => NLW_U0_rdaddrecc_UNCONNECTED(6 downto 0),
      regcea => '0',
      regceb => '0',
      rsta => '0',
      rsta_busy => NLW_U0_rsta_busy_UNCONNECTED,
      rstb => '0',
      rstb_busy => NLW_U0_rstb_busy_UNCONNECTED,
      s_aclk => '0',
      s_aresetn => '0',
      s_axi_araddr(31 downto 0) => B"00000000000000000000000000000000",
      s_axi_arburst(1 downto 0) => B"00",
      s_axi_arid(3 downto 0) => B"0000",
      s_axi_arlen(7 downto 0) => B"00000000",
      s_axi_arready => NLW_U0_s_axi_arready_UNCONNECTED,
      s_axi_arsize(2 downto 0) => B"000",
      s_axi_arvalid => '0',
      s_axi_awaddr(31 downto 0) => B"00000000000000000000000000000000",
      s_axi_awburst(1 downto 0) => B"00",
      s_axi_awid(3 downto 0) => B"0000",
      s_axi_awlen(7 downto 0) => B"00000000",
      s_axi_awready => NLW_U0_s_axi_awready_UNCONNECTED,
      s_axi_awsize(2 downto 0) => B"000",
      s_axi_awvalid => '0',
      s_axi_bid(3 downto 0) => NLW_U0_s_axi_bid_UNCONNECTED(3 downto 0),
      s_axi_bready => '0',
      s_axi_bresp(1 downto 0) => NLW_U0_s_axi_bresp_UNCONNECTED(1 downto 0),
      s_axi_bvalid => NLW_U0_s_axi_bvalid_UNCONNECTED,
      s_axi_dbiterr => NLW_U0_s_axi_dbiterr_UNCONNECTED,
      s_axi_injectdbiterr => '0',
      s_axi_injectsbiterr => '0',
      s_axi_rdaddrecc(6 downto 0) => NLW_U0_s_axi_rdaddrecc_UNCONNECTED(6 downto 0),
      s_axi_rdata(31 downto 0) => NLW_U0_s_axi_rdata_UNCONNECTED(31 downto 0),
      s_axi_rid(3 downto 0) => NLW_U0_s_axi_rid_UNCONNECTED(3 downto 0),
      s_axi_rlast => NLW_U0_s_axi_rlast_UNCONNECTED,
      s_axi_rready => '0',
      s_axi_rresp(1 downto 0) => NLW_U0_s_axi_rresp_UNCONNECTED(1 downto 0),
      s_axi_rvalid => NLW_U0_s_axi_rvalid_UNCONNECTED,
      s_axi_sbiterr => NLW_U0_s_axi_sbiterr_UNCONNECTED,
      s_axi_wdata(31 downto 0) => B"00000000000000000000000000000000",
      s_axi_wlast => '0',
      s_axi_wready => NLW_U0_s_axi_wready_UNCONNECTED,
      s_axi_wstrb(3 downto 0) => B"0000",
      s_axi_wvalid => '0',
      sbiterr => NLW_U0_sbiterr_UNCONNECTED,
      shutdown => '0',
      sleep => '0',
      wea(3 downto 0) => wea(3 downto 0),
      web(3 downto 0) => B"0000"
    );
end STRUCTURE;
