SocialistDalao/UltraMIPS_Cache/(commit log)

2020-07-06 FIFO half finished, but still need to fix some errors
    [WriteBuffer.v, defines_cache.v]
2020-07-08 change the design of state in code and also correct some related codes, but still not complete
    [非流水状态机DCache行为.xlsx]
2020-07-08 FIFO optimization of collision WR
    [WriteBuffer.v]
2020-07-09 correct some error in DCache and CacheAXI_Interface, and successfully run synthesis of DCache
    [CacheAXI_Interface.v, WriteBuffer.v, defines_cache.v, xsimSettings.ini]
2020-07-11 Find a lot errors in Buffer/DCache/Interface, and only ICache stall is not completed. Next step we will move to simulation of Interface, FIFO, DCache.
    [CacheAXI_Interface.v, WriteBuffer.v]
2020-07-14 WriteBuffer has critical errors in design
    [WriteBuffer.v]
2020-07-16 Write Buffer redesigned, but interaction signals are founch which causes the failure of synthesis
    [WriteBuffer.v]
2020-07-20 Dual Issue CPU ICache constructed.
    [ICacheAXI_Interface.v, defines_cache.v, my_axi_interface.v, mycpu_top.v]
2020-07-25 ICache port renamed and redesigned
    [Cache.v, CacheAXI_Interface.v, mycpu_top.v]
2020-08-01 Unsual ICache flush related stop problems solved, bpu structure succeeded
    [CacheAXI_Interface.v, defines.v, defines_cache.v]
2020-08-06 DCache optimized to 87MHZ and renamed with some variables
    [score.xls]
