SocialistDalao/UltraMIPS_Cache/(notices)

Notices in the files:
Resource/PastVersion/7.28noon/ctrl.v:
Copyright (C) 2014 leishangwen@163.com
Public License as published by the Free Software Foundation;
